kblueseek/GongChuang/docs/引脚分配表.md

# STM32F407VET6 引脚接线表（底盘 CAN 版）

> 依据当前工程实际配置整理：`UniversalCar.ioc` / `can.c` / `usart.c` / `tim.c` / `gpio.c` / `RobotConfig.h`
> 控制器：**STM32F407VET6**（LQFP100，512KB Flash / 192KB RAM）
> 系统时钟 168MHz（HSE **8MHz**，PLLM=4 / PLLN=168 / PLLP=2）
> 更新日期：2026-10-09
> ⚠️ 电机总线走 **CAN1**（500K 扩展帧，7 个 ZDT 电机并联，需 CAN 收发器）；电机固件为 **Emm**。

---

## 〇、接口总表（一张表看全部）

| 板上丝印 | MCU 引脚 | 外设 | 方向 | 接到哪 | 备注 |
|---|---|---|---|---|---|
| B9  | PB9  | CAN1_TX | 输出 | CAN 收发器 TXD | 500K 扩展帧 |
| B8  | PB8  | CAN1_RX | 输入 | CAN 收发器 RXD | 500K |
| A9  | PA9  | USART1_TX | 输出 | 调试上位机 RXD | 115200，DMA |
| A10 | PA10 | USART1_RX | 输入 | 调试上位机 TXD | 115200 |
| A2  | PA2  | USART2_TX | 输出 | （原蓝牙模组，已停用） | 115200 |
| A3  | PA3  | USART2_RX | 输入 | （原蓝牙模组，已停用） | 115200 |
| B10 | PB10 | USART3_TX | 输出 | JY901S RXD | 115200 |
| B11 | PB11 | USART3_RX | 输入 | JY901S TXD | 115200 |
| C6  | PC6  | USART6_TX | 输出 | 树莓派 RXD | 115200，**主链路：指令上行 + 遥测下行** |
| C7  | PC7  | USART6_RX | 输入 | 树莓派 TXD | 115200 |
| C10 | PC10 | UART4_TX | 输出 | （原 LoRa 模组，已停用） | 115200 |
| C11 | PC11 | UART4_RX | 输入 | （原 LoRa 模组，已停用） | 115200 |
| C12 | PC12 | UART5_TX | 输出 | （预留，原电机串口） | 已切 CAN |
| D2  | PD2  | UART5_RX | 输入 | （预留） | 已切 CAN |
| A6  | PA6  | TIM3_CH1 | 输出 | 舵机1 夹爪 信号 | 50Hz PWM |
| A7  | PA7  | TIM3_CH2 | 输出 | 舵机2 载物盘 信号 | 50Hz PWM |
| B0  | PB0  | TIM3_CH3 | 输出 | 舵机3 摄像头 信号 | 50Hz PWM |
| A13/A14 | PA13/PA14 | SWD | — | 下载排针 | ⚠️ 禁止外接 |
| H0/H1 | PH0/PH1 | HSE | — | 8MHz 无源晶振 | 负载电容 2×20pF |

---

## 一、电机 CAN 总线（CAN1，本次重点）

### 1.1 接线（CAN 多机并联）

CAN 是差分总线，**必须经过 CAN 收发器**（3.3V 逻辑 ↔ CAN_H/CAN_L），所有电机收发器并联在同一条总线上：

```
STM32 CAN1_TX (PB9) ──► 收发器.TXD
STM32 CAN1_RX (PB8) ◄── 收发器.RXD
收发器.CAN_H ─────────┬─────────┬─────────┬ ...（并到每个电机的 CAN_H）
收发器.CAN_L ─────────┼─────────┼─────────┼ ...（并到每个电机的 CAN_L）
GND ─────────────────┴─────────┴─────────┴ ...
```

- **CAN_H / CAN_L 全并联**，总线**两端各接一个 120Ω 终端电阻**（PCAN 端通常已带一个，另一端在电机总线末端补一个）。
- 波特率 **500K**，扩展帧，校验固定 **0x6B**。
- 多机靠**扩展帧 ID 区分地址**，全双工差分，不需要像串口那样分时问答。

### 1.2 电机地址表（CAN 扩展帧 ID = 地址<<8 | 包序号）

| 地址 | 电机 | 角色 | 控制模式 | 固件 |
|---|---|---|---|---|
| 1 | 底盘 前左 FL | 麦轮 | 速度模式（F6） | Emm |
| 2 | 底盘 前右 FR | 麦轮 | 速度模式（F6） | Emm |
| 3 | 底盘 后左 RL | 麦轮 | 速度模式（F6） | Emm |
| 4 | 底盘 后右 RR | 麦轮 | 速度模式（F6） | Emm |
| 5 | 云台 Yaw | 旋转轴 | 绝对位置模式（FD） | Emm |
| 6 | 云台 Lift | 升降轴 | 绝对位置模式（FD） | Emm |
| 7 | 云台 Extend | 伸缩轴 | 绝对位置模式（FD） | Emm |

> ⚠️ **每台电机都要用上位机把「通讯端口复用」设成 CAN(03)**，地址设成 1~7，波特率 500K，校验 0x6B。
> ⚠️ 固件是 **Emm**：速度命令 `F6 + 方向 + 速度(RPM) + 加速度档位 + 同步标志`，位置命令 `FD`，与 X 固件格式不同。

### 1.3 底盘多电机命令（0xAA）

底盘四个轮速用**多电机命令 0xAA** 打包成一条广播帧下发（`00 AA 长度 + 四条子命令 + 6B`，CAN 上按包序拆成扩展帧 ID `0000/0001/...`），四轮同步起步、只有地址 1 回 ACK，避免总线冲突。

### 1.4 编码器反馈（定时返回 0x36）

每台底盘电机配置了「定时返回实时位置 0x36」，每 `ZDT_FEEDBACK_PERIOD_MS`（默认 5ms）主动上报一次编码器位置（多圈累计，65536 计数 = 一圈），STM32 用整数计数差分积分成里程计，供回零位置闭环使用。

---

## 二、三个舵机（TIM3，50Hz / 20ms）

| 引脚 | 通道 | 舵机 | 上电初始角 |
|---|---|---|---|
| PA6 | TIM3_CH1 | 夹爪 | 90° |
| PA7 | TIM3_CH2 | 载物盘 | 0° |
| PB0 | TIM3_CH3 | 摄像头 | 90° |

- 信号线直接接 3.3V 电平即可（舵机高电平阈值一般 2.0~2.4V）。
- **电源线（红）走独立 5~6V 轨**，不要从单片机 3.3V 取；共地。

---

## 三、串口分配

| 串口 | 引脚 | 对象 | 波特率 | 说明 |
|---|---|---|---|---|
| USART1 | PA9/PA10 | 调试上位机 | 115200 | DMA 发送 DebugData 包 |
| USART2 | PA2/PA3 | （原蓝牙模组） | 115200 | 已停用（无线方案已换成有线） |
| USART3 | PB10/PB11 | JY901S | 115200 | ⚠️ 模块默认 9600，需先改成 115200 |
| USART6 | PC6/PC7 | 树莓派（有线） | 115200 | **主链路**：指令上行 + 遥测下行，全双工 |
| UART4 | PC10/PC11 | （原 LoRa 模组） | 115200 | 已停用（遥测改走 USART6） |
| UART5 | PC12/PD2 | 预留 | — | 原电机串口，已切 CAN |

---

## 四、电源与共地

| 设备 | 供电轨 | 备注 |
|---|---|---|
| 7 个步进电机 | 24V 直供 | 峰值电流大，主线加粗/铺铜 |
| CAN 收发器 | 3.3V / 5V | 按收发器型号供电 |
| 舵机 ×3 | 5~6V 独立轨 | 堵转 1~2A |
| STM32 核心板 | 5V | <0.5A |
| 树莓派 | 5V/5A | 独立电源，但 **GND 必须与 F407 共地**（有线串口 USART6） |

**F407 侧设备 GND 共地**：CAN 收发器、各串口、舵机、电源都要接到同一地平面。
**⚠️ 树莓派必须与 F407 共地**：现在走有线 USART6（全双工），UART 是电平信号，
没有公共地就没有电平参考，通信会乱码或完全不通。树莓派和 F407 的 GND 用一根线直连。

---

## 五、预留（本版未接线）

| 资源 | 引脚 | 用途 |
|---|---|---|
| UART5 | PC12/PD2 | 预留（原电机串口，已切 CAN） |
| UART4_RX | PC11 | LoRa 模组 TXD 接这里；当前方案只发不收，留作回传扩展 |
| TIM2_CH1 | PA5 | 补光灯 PWM（可选） |
| 硬件急停 | 任意 GPIO/EXTI | 未配置，预留 |
| 状态 LED | PC13 | 板载，当前代码未配置 |

---

## 六、接线顺序建议（Bring-up）

1. 先接 **CAN 电机总线**：接好 CAN 收发器，把 4 个底盘电机（+收发器）并联到 CAN_H/CAN_L，上位机把每台电机通讯端口切 CAN、设地址 1~4，PCAN/串口助手发 `01 36 6B` 读位置验证。
2. 再接 **3 个舵机**，上电确认回中位。
3. 接 **JY901S（USART3）**，先确认已改 115200。
4. 接 **树莓派有线串口**：F407 USART6（PC6=TX → 树莓派 GPIO15/RX，PC7=RX → 树莓派 GPIO14/TX），
   再拉一根 GND 共地，两边都 115200。验证：`ros2 launch lidar_bringup car_only.launch.py`，
   或单独跑桥接节点看日志里的「上行链路已连接」。
5. 最后接 **调试口（USART1）**。

---

## ⚠️ 容易踩的点

1. **晶振是 8MHz**：`.ioc` 配的是 HSE **8MHz**（PLLM=4 / PLLN=168 / PLLP=2）。接好前确认板载晶振确实是 8MHz，不是 25MHz，否则系统时钟不对。
2. **电机通讯模式**：每台电机默认/之前可能是串口模式，必须用上位机切成 **CAN** 并设对地址（1~7）、波特率 500K、校验 0x6B，否则对 CAN 命令没反应。
3. **CAN 收发器必接**：CAN 是差分信号，ST 的 PB8/PB9 是逻辑电平，不接收发器直接并线读不到也发不出。
4. **终端电阻**：总线两端各 120Ω，少了长线会反射、通讯不稳。
5. **固件 Emm**：速度/位置命令格式和 X 固件不同（速度=整数RPM+档位加速度，位置=FD），抄协议时别用 X 固件的格式。
6. **JY901S**：USART3 按 115200 配，但模块出厂默认 9600，需先用上位机改成 115200 再接线。

# 树莓派 已分配引脚
| 功能 | 接口 | BCM | 物理脚 | 电平/说明 |
| ---- | ---- | ---- | ---- | ---- |
| （原 STM32 LoRa TX） | UART2 | GPIO4 | 7 | 已停用（有线方案） |
| （原 STM32 LoRa RX） | UART2 | GPIO5 | 29 | 已停用（有线方案） |
| 状态屏 SDA | I2C1 | GPIO2 | 3 | OLED 1.96 寸，地址一般 0x3C |
| 状态屏 SCL | I2C1 | GPIO3 | 5 |  |
| STM32 有线 TX | UART0 | GPIO14 | 8 | 主链路，接 F407 USART6_RX（PC7） |
| STM32 有线 RX | UART0 | GPIO15 | 10 | 主链路，接 F407 USART6_TX（PC6） |
| 激光雷达 | USB | — | — | USB 转串口，固定为 /dev/ydlidar |
| 手柄 | USB | — | — | /dev/input/js0 |
| 补光灯 PWM | PWM0 | GPIO18 | 12 | 板上加 MOSFET，不能直驱 |
| 按键 1 | GPIO | GPIO17 | 11 | 上拉 + RC 消抖，云台限位示教：跳过当前轴 |
| 按键 2 | GPIO | GPIO22 | 15 | 同上，云台限位示教：当前轴重来 |
| 按键 3 | GPIO | GPIO23 | 16 | 同上，云台限位示教：记录当前点；非示教时翻屏 |
| 按键 4 | GPIO | GPIO24 | 18 | 同上，云台限位示教：退出示教 |

> 云台限位示教（status_display 节点）：开机后自动让 F407 把云台三轴松轴，按
> YAW → LIFT(Z) → EXTEND(X) 的顺序，把轴用手拨到想要的最小点/最大点，各按一次
> 按键 3 记录；结果保存到树莓派 `~/.ros/gimbal_limits.json` 并下发给 F407。
> 详细流程见 `raspberrypi/docs/树莓派构建指南.md`。
| OPS9 TX（预留） | UART5 | GPIO12 | 32 | 确认型号后启用 |
| OPS9 RX（预留） | UART5 | GPIO13 | 33 |  |
| I2C1 | I2C1 | GPIO2 / GPIO3 | 3 / 5 | 已给状态屏使用 |
| OPS9 备用 SPI | SPI0 | GPIO8/9/10/11 | 24/21/19/23 | CE0/MISO/MOSI/SCLK |
