kblueseek/GongChuang/raspberrypi/docs/树莓派构建指南.md

# 树莓派项目构建指南

目标平台：树莓派（推荐 4B/5）+ **Ubuntu 26.04** + **ROS2 Lyrical Luth**（Ubuntu 26.04 对应的 LTS 发行版）。

本文从零讲清：硬件接线 → 系统/ROS2 → 串口 → YDLIDAR 驱动 → 构建 → 运行 → 联调顺序 → 排错。

---

## 0. 角色与数据流

树莓派是决策层，F407 是执行层：

- 树莓派**只下发目标**（速度 / 云台角度 / 舵机 / 使能），电机 PID 闭环在 F407 上 20kHz 完成；
- F407 通过遥测回传里程计 `0x81`、整车状态 `0x83` 和云台三轴位置 `0x84`（里程计 50Hz、云台位置 20Hz、状态 5Hz，USART6 115200）；
- 树莓派串口与 F407 USART6（PC6/PC7，115200 8N1）直连，两端均为 **3.3V TTL**，共地即可，无需电平转换。

```
激光雷达 ──/scan──> obstacle_detect ──/obstacles──┐
                                                  v
上位机地图(扫描/识别/A*) ──/motion_load(序列)──> motion_planner ──/cmd_pose──┐
                                                  ^                          v
                                       ring_fix（视觉矫正 /set_odom）   f407_bridge ──PiComm(AA 55)──> F407 USART6
                                                  ^                          ^
                                        joy_control（手柄）          /odom /robot_status /odom_shift <──┘
```

---

## 1. 硬件接线

| 信号 | F407（USART6） | 树莓派 GPIO | 备注 |
|---|---|---|---|
| TX | PC6 | RXD（GPIO15，UART0_RX） | 交叉连接 |
| RX | PC7 | TXD（GPIO14，UART0_TX） | 交叉连接 |
| GND  | GND | GND | 必须共地 |
| 激光雷达 | —— | USB 口 | YDLIDAR X3 PRO 自带 USB 转串口 |

> 接线图参考仓库根目录 `docs/树莓派拓展版接线.png`。

---

## 2. 系统与 ROS2

1. 烧录 Ubuntu 26.04（Server 或 Desktop 均可；视觉需要图形环境，用 Desktop 更省事）。
2. 安装 ROS2 Lyrical Luth 桌面版，官方步骤（把页面里的发行版换成 `lyrical`）：
   <https://docs.ros.org/en/rolling/Installation/Ubuntu-Install-Debs.html>
3. 验证：
   ```bash
   source /opt/ros/lyrical/setup.bash
   ros2 --help
   ```

---

## 3. 串口（Pi ↔ F407）

Ubuntu 下在 `config.txt`（`/boot/firmware/config.txt` 或 `/boot/config.txt`）追加：

```
enable_uart=1
dtoverlay=disable-bt      # Pi 3/4 释放与蓝牙复用的 UART；Pi 5 可省略
```

重启后串口映射到 `/dev/serial0`（通常是 `/dev/ttyAMA0`）。验证：

```bash
ls -l /dev/serial0 /dev/ttyAMA0
```

> 首次联调可先脱离 ROS2 单独验证串口 + 协议，见 §6。

---

## 4. YDLIDAR X3 PRO 驱动

1. 建 udev 规则，把激光雷达固定成 `/dev/ydlidar`（脚本已生成，这里列出内容）：
   ```bash
   sudo tee /etc/udev/rules.d/ydlidar.rules >/dev/null <<'EOF'
   KERNEL=="ttyUSB*", ATTRS{idVendor}=="10c4", ATTRS{idProduct}=="ea60", MODE:="0666", SYMLINK+="ydlidar"
   EOF
   sudo udevadm control --reload-rules && sudo udevadm trigger
   ```
   > 若 `lsusb` 显示的 VID/PID 不是 `10c4:ea60`，据实修改。X3 PRO 用 CP2102 串口芯片。

2. 拉取并构建官方驱动（含 YDLidar-SDK 子模块）：
   ```bash
   cd ~/GongChuang/树莓派/ros2_ws/src
   git clone --recursive https://github.com/YDLIDAR/ydlidar_ros2_driver.git
   ```
   驱动参数见 [car_bringup/config/x3_pro.yaml](../ros2_ws/src/car_bringup/config/x3_pro.yaml)。

---

## 5. 构建与运行

```bash
cd ~/GongChuang/树莓派
bash scripts/setup.sh       # 依赖 + 串口 + udev + 驱动 clone + colcon build
sudo reboot
bash scripts/bringup.sh     # = ros2 launch car_bringup system.launch.py
```

单节点调试（不启动总 launch）：

```bash
source /opt/ros/lyrical/setup.bash
source ~/GongChuang/树莓派/ros2_ws/install/setup.bash

ros2 launch car_bringup x3_pro.launch.py    # 只起雷达，先确认有 /scan
ros2 run obstacle_detect obstacle_detect_node # 看 /obstacles
ros2 run f407_bridge f407_bridge_node         # 看 /odom /robot_status
ros2 run motion_planner motion_planner_node   # 状态机（/motion_load 下发序列）
ros2 run ring_fix ring_fix_node               # 圆环视觉矫正（calibrate 指令）
```

常用检查：

```bash
ros2 topic list
ros2 topic echo /scan --once            # 有数据说明雷达通
ros2 topic echo /obstacles              # [front, left, right, back] 米
ros2 topic echo /odom
ros2 topic echo /robot_status
```

---

## 5.5 云台限位示教（开机自动）

`status_display` 节点同时是限位示教面板：开机 3 秒后自动让 F407 把云台三轴**松轴**
（电机控制板失能，F3 AB 00），然后提示你用手把轴拨到想要的位置。

| 步骤 | 屏幕提示 | 操作 |
|---|---|---|
| 1/3 | `SETUP 1/3 YAW -> MIN point` | 手拨 Yaw 到最小点，按**按键3**（GPIO23） |
| 1/3 | `SETUP 1/3 YAW -> MAX point` | 拨到最大点，再按**按键3** |
| 2/3 | `SETUP 2/3 LIFT -> MIN/MAX` | Z 升降轴，同上两次 |
| 3/3 | `SETUP 3/3 EXT -> MIN/MAX` | X 伸缩轴，同上两次 |
| 完成 | `限位示教完成并已下发` | 恢复锁轴，限位立即生效 |

按键：

- **按键3 GPIO23**：记录当前点；非示教时翻页（状态 / 云台位置 / 限位）。
- **按键1 GPIO17**：跳过当前轴（保留上次保存的限位）。
- **按键2 GPIO22**：当前轴重来（丢掉刚记的最小点）。
- **按键4 GPIO24**：退出示教（已经记下的轴生效，其余用上次保存值）。

示教结果保存在 `~/.ros/gimbal_limits.json`，并通过 `0x0B` 下发给 F407；F407 之后
就按这组限位在速度指令上掐掉越界方向。节点在示教完成后还会 1Hz 重发一次限位，
F407 中途重启也能补上。

⚠️ **限位坐标是"相对 F407 上电位置"**：F407 每轴上电后第一次收到编码器反馈时把
那一刻锁存成 0 点。所以：
- 每次 F407 重新上电，0 点都会变，**建议每次开机都示教一遍**（默认自动进入）；
- 用按键4 跳过时下发的是上次保存的限位，只有"这次上电时轴的位置和上次一样"才准，
  屏幕第 3 页会显示 `OLD? re-teach if pose changed` 提醒；
- 示教过程中树莓派掉线，F407 会自动恢复锁轴并停发速度（安全兜底）。

相关参数（`status_display` 节点）：`auto_setup`（默认 true）、`startup_delay_s`（3.0）、
`min_span_deg`（20.0）、`limits_file`、四个 `button_*_pin`。

⚠️ **限位方向符号**：F407 判断限位前要把速度指令换算到编码器坐标，靠
`RobotConfig.h` 里的 `GIMBAL_YAW_CMD_SIGN` / `GIMBAL_LIFT_CMD_SIGN` /
`GIMBAL_EXTEND_CMD_SIGN`（+1 / -1）。编码器计数方向和电机转向相反的轴要填 -1
（出厂 Yaw 为 -1）。填反的现象是：顶到限位后**往回拨不动、继续往越界方向反而能动**。

---

## 6. 联调顺序（强烈建议按序）

不要一上来就发速度。按下面顺序逐步验证：

1. **心跳 / 状态**：先跑 `comm/pi_comm.py` 自检脚本，确认能收到 `0x83` 状态帧：
   ```bash
   python3 comm/pi_comm.py /dev/serial0
   ```
   收到 `状态: (state, err, motor_mask)` 且 `motor_mask == 0x7F`（7 个电机全在线）再继续。

2. **里程计**：推动小车，`/odom` 的 x/y/theta 应随之变化（单位/方向核对）。

3. **使能**：`ros2 topic pub /cmd_enable std_msgs/msg/Bool "data: true"`，F407 进入 `ROBOT_READY`。

4. **低速前进**：
   ```bash
   ros2 topic pub /cmd_vel geometry_msgs/msg/Twist \
     "{linear: {x: 0.1, y: 0.0, z: 0.0}, angular: {x: 0.0, y: 0.0, z: 0.0}}"
   ```

5. **急停**：任何异常立即 `ros2 topic pub /cmd_estop std_msgs/msg/Bool "data: true"`。

---

## 7. 单位与坐标系约定

- PiComm 速度帧：vx/vy 单位 **mm/s**，wz 单位 **mrad/s**（`encode_vel` 负责从 m/s、rad/s 换算）；
- 里程计帧：x/y 单位 **mm**，theta 单位 **mrad**（`parse_odom` 换算成 m、rad 后发 `/odom`）；
- 舵机角度 0~180°；
- `/obstacles`：`[front, left, right, back]`，单位米，`left` 为车辆左侧（90°），`right` 为 270°。

---

## 8. 已知事项 / TODO

- **协议迁移**：`vision/` 主程序仍用旧串口协议（`AA xx BB / CC xx DD`，见 `vision/串口通信协议.md`），
  与 PiComm（`AA 55 ...`）冲突。圆环工位识别已由 `ring_fix` 直接 import 检测器模块走 ROS2；
  其余模式（转盘/物料）的迁移方式相同。
- **视觉无头运行**：`vision/main.py` 用 `cv2.imshow` 显示窗口，无显示器环境需 X 转发或改造为
  headless（TODO）。
- **任务流程**：取放/码放由上位机组装指令序列（pick/place 宏、vision_pick、calibrate）下发
  motion_planner 执行，详见 [树莓派架构.md](树莓派架构.md)。

---

## 9. 常见问题

| 现象 | 排查 |
|---|---|
| `/scan` 无数据 | `ls -l /dev/ydlidar`；驱动是否 build 成功；USB 供电是否足够（换带供电的 USB HUB） |
| 串口收不到帧 | 检查 TX/RX 是否交叉、是否共地；`config.txt` 是否 `enable_uart=1`；波特率是否 115200（F407 与树莓派两端一致） |
| `motor_mask != 0x7F` | 对应电机离线或 CAN 未上电，查 F407 侧 CAN/电机电源 |
| 收到帧但 CRC 错 | 波特率不匹配、线材过长、或两边协议版本不一致——**逐字节核对 PiComm.c** |
| colcon build 失败 | 确认已 source ROS2；`python3-colcon-common-extensions` 已装 |
| 顶到限位后往回拨不动、越界方向能动 | 该轴的 `GIMBAL_xx_CMD_SIGN` 填反（`RobotConfig.h`），改 ±1 后重编 F407 |
