kblueseek/GongChuang/docs/下板.png

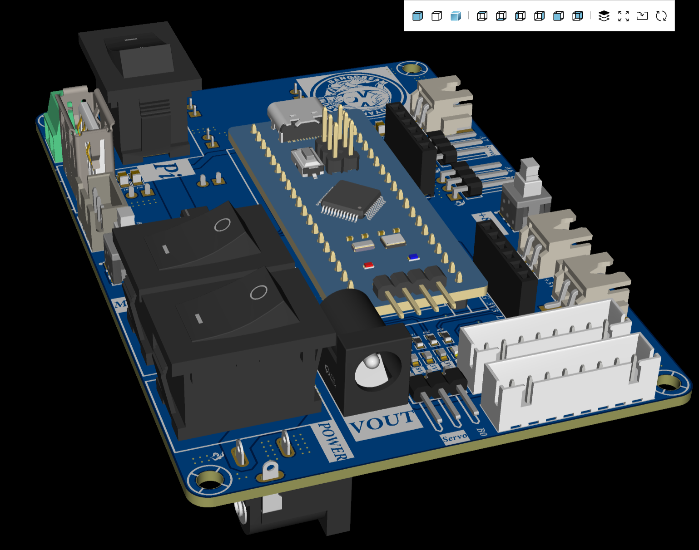
docs/下板.png
