kblueseek/GongChuang/docs/树莓派拓展版接线.png

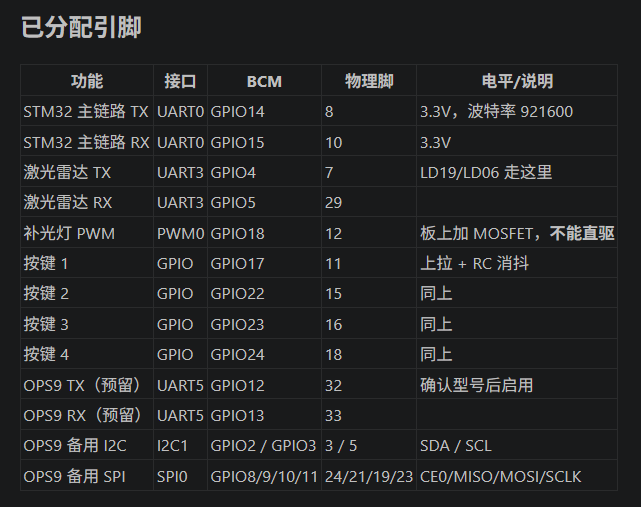
docs/树莓派拓展版接线.png
