kblueseek/GongChuang/docs/项目方案/图1_系统总体架构.png

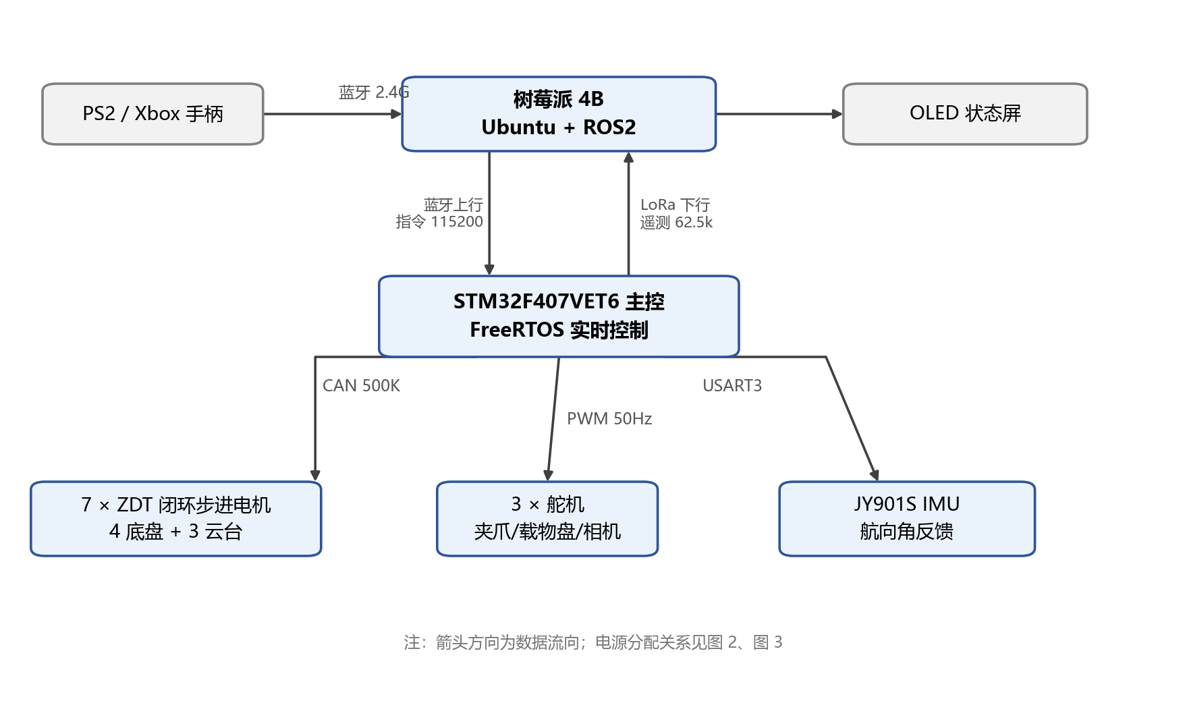
docs/项目方案/图1_系统总体架构.png
