kblueseek/GongChuang/UniversalCar/UniversalCar.ioc

Mcu.UserName=STM32F407VETx
PA10.Signal=USART1_RX
PA13.Signal=SYS_JTMS-SWDIO
PA14.Signal=SYS_JTCK-SWCLK
PA2.Signal=USART2_TX
PA3.Signal=USART2_RX
PA5.Signal=S_TIM2_CH1_ETR
PA6.Signal=S_TIM3_CH1
PA7.Signal=S_TIM3_CH2
PA9.Signal=USART1_TX
PB0.Signal=S_TIM3_CH3
PB10.Signal=USART3_TX
PB11.Signal=USART3_RX
PB8.Signal=CAN1_RX
PB9.Signal=CAN1_TX
PC10.Signal=UART4_TX
PC11.Signal=UART4_RX
PC12.Signal=UART5_TX
PC6.Signal=USART6_TX
PC7.Signal=USART6_RX
PD2.Signal=UART5_RX
PH0-OSC_IN.Signal=RCC_OSC_IN
PH1-OSC_OUT.Signal=RCC_OSC_OUT
