kblueseek/GongChuang/UniversalCar/ExHardware/ZdtMotor.c

/**
 * @attention   采用UTF-8字符集编码
 * @brief       ZDT Y42 闭环步进电机 CAN 控制封装（Emm 固件）
 * @details     电机内部闭环，STM32 侧不跑电流/速度环，直接下发速度或位置指令。
 *              采用注册机制维护地址表，统一了所有电机的维护与反馈解析。
 */

#include "header.h"

#define ZDT_CHECKSUM 0x6B
#define ZDT_TX_TIMEOUT_MS 1   /* 等空闲邮箱的最长时间（ms）：500k 下一帧约 250us，够等 3~4 次 */

ZdtMotor_t* ZdtMotorList[8] = { NULL };

/* 发送一帧（单包），扩展帧 ID = (地址<<8)|包序号 */
static uint8_t Zdt_SendFrame(uint8_t addr, uint8_t packet, const uint8_t* d, uint8_t n)
{
    CAN_TxHeaderTypeDef tx = { 0 };
    uint32_t mb;
    tx.ExtId = ((uint32_t)addr << 8) | packet;
    tx.IDE = CAN_ID_EXT;
    tx.RTR = CAN_RTR_DATA;
    tx.DLC = n;

    /* CAN1 只有 3 个 TX 邮箱，全满时 HAL_CAN_AddTxMessage 直接返回 HAL_ERROR（丢帧）。
       底盘任务背靠背连发一整串广播包，必须等空闲邮箱；但不能死等：bus-off 时 HAL 会
       一直立即返回错误，纯空转能把 10ms 任务卡十几毫秒。这里按时间封顶。
       现在全总线只有底盘任务发帧，不会再有另一个任务来抢邮箱（之前云台任务也发，
       两边互相挤，多包广播丢一包就整帧作废——"底盘卡住"、某轴"完全没反应"）。 */
    HAL_StatusTypeDef ret = HAL_CAN_AddTxMessage(&hcan1, &tx, (uint8_t*)d, &mb);
    uint32_t t0 = HAL_GetTick();
    while (ret != HAL_OK && (HAL_GetTick() - t0) < ZDT_TX_TIMEOUT_MS)
    {
        osThreadYield();
        ret = HAL_CAN_AddTxMessage(&hcan1, &tx, (uint8_t*)d, &mb);
    }
    return (ret == HAL_OK);
}

/* 低层发送：cmd[0] 为功能码，追加校验码后拆包发送。
   手册 4.2：CAN 拆包时每包首字节都要重复功能码，数据每包最多 7 字节，
   例如 12 字节命令拆成 "FD xx xx xx xx xx xx xx" + "FD xx xx xx 6B"。 */
static void Zdt_MotorSend(uint8_t addr, const uint8_t* cmd, uint8_t len)
{
    uint8_t func = cmd[0];
    uint8_t dataLen = len - 1;          /* 功能码之外的数据字节数 */
    uint8_t total = dataLen + 1;        /* 数据 + 校验码 */
    uint8_t sent = 0, packet = 0;

    while (sent < total) {
        uint8_t n = (total - sent > 7) ? 7 : (total - sent);
        uint8_t buf[8];
        buf[0] = func;                  /* 每包首字节重复功能码 */
        for (uint8_t i = 0; i < n; i++) {
            uint8_t idx = sent + i;
            buf[1 + i] = (idx < dataLen) ? cmd[1 + idx] : ZDT_CHECKSUM;
        }
        Zdt_SendFrame(addr, packet, buf, n + 1);
        sent += n;
        packet++;
    }
}

/* ============ 电机实例维护 ============ */

void ZdtMotor_Init(ZdtMotor_t* motor, uint8_t addr)
{
    motor->Addr = addr;
    motor->Speed.Set = 0;
    motor->Speed.Real = 0;
    motor->Position.Set = 0;
    motor->Position.Real = 0;
    motor->Position.RawCount = 0;
    motor->Status = 0;
    motor->HomeStatus = 0;
    motor->LastOnlineTick = 0;

    if (addr >= 1 && addr <= 7)
        ZdtMotorList[addr] = motor;
}

int ZdtMotor_IsOnline(ZdtMotor_t* motor)
{
    return (HAL_GetTick() - motor->LastOnlineTick) < ZDT_OFFLINE_MS;
}

/* ============ CAN 总线命令 ============ */

void ZdtCan_Init(void)
{
    CAN_FilterTypeDef f = { 0 };
    f.FilterActivation = CAN_FILTER_ENABLE;
    f.FilterBank = 0;
    f.FilterFIFOAssignment = CAN_RX_FIFO0;
    f.FilterIdHigh = 0;
    f.FilterIdLow = 0;
    f.FilterMaskIdHigh = 0;
    f.FilterMaskIdLow = 0;
    f.FilterMode = CAN_FILTERMODE_IDMASK;
    f.FilterScale = CAN_FILTERSCALE_32BIT;
    f.SlaveStartFilterBank = 14;    /* F4 双 CAN 时必须写，否则 HAL 返回 HAL_ERROR */
    HAL_CAN_ConfigFilter(&hcan1, &f);
    HAL_CAN_Start(&hcan1);
    HAL_CAN_ActivateNotification(&hcan1, CAN_IT_RX_FIFO0_MSG_PENDING);
}

void ZdtCan_Enable(uint8_t addr, uint8_t en)
{
    uint8_t c[] = { 0xF3, 0xAB, en ? 1 : 0, 0x00 };
    Zdt_MotorSend(addr, c, sizeof(c));
}

void ZdtCan_Stop(uint8_t addr)
{
    uint8_t c[] = { 0xFE, 0x98, 0x00 };
    Zdt_MotorSend(addr, c, sizeof(c));
}

void ZdtCan_SetZero(uint8_t addr)
{
    uint8_t c[] = { 0x0A, 0x6D };
    Zdt_MotorSend(addr, c, sizeof(c));
}

/* 解除堵转保护（手册 5.4.x：0x0E 0x52）。
   电机撞限位堵转后，固件会把保护标志【锁存】：位置反馈照常回（所以在状态掩码里显示
   在线），但拒绝一切速度/位置命令——表现就是"电机在线，可怎么按都不动"，
   必须掉电重启才恢复。这条命令就是软件侧的"重启"，使能时补一帧即可。 */
void ZdtCan_ClearStall(uint8_t addr)
{
    uint8_t c[] = { 0x0E, 0x52 };
    Zdt_MotorSend(addr, c, sizeof(c));
}

void ZdtCan_Home(uint8_t addr, uint8_t mode)
{
    uint8_t c[] = { 0x9A, mode, 0x00 };
    Zdt_MotorSend(addr, c, sizeof(c));
}

void ZdtCan_SyncAll(void)
{
    uint8_t c[] = { 0xFF, 0x66 };
    Zdt_MotorSend(0, c, sizeof(c));   /* 广播地址 0 */
}

void ZdtCan_ReadPos(uint8_t addr)
{
    uint8_t c[] = { 0x36 };
    Zdt_MotorSend(addr, c, sizeof(c));
}

void ZdtCan_ReadStatus(uint8_t addr)
{
    uint8_t c[] = { 0x3C };
    Zdt_MotorSend(addr, c, sizeof(c));
}

/* 定时返回信息命令（手册 5.5.1）：让电机每隔 interval_ms 自动上报指定信息，无需频繁轮询。
   func 为要返回的信息功能码：0x36=实时位置(4B,65536/圈)，0x35=实时转速(RPM)，0x3A=状态标志等。
   interval_ms=0 表示停止返回。 */
void ZdtCan_SetTimedReturn(uint8_t addr, uint8_t func, uint16_t interval_ms)
{
    uint8_t c[] = { 0x11, 0x18, func, interval_ms >> 8, interval_ms & 0xFF };
    Zdt_MotorSend(addr, c, sizeof(c));
}

/* ============ 多电机命令 (0xAA)：一条广播帧发多个电机命令，同时执行 ============ */
/* 手册 5.3.1：00 AA 总字节数(2) + 各子命令(地址+功能码/数据+校验码) + 校验码，
   地址 0 为广播，所有电机同时开始；CAN 上按功能码重复规则拆包。
   组帧缓冲放在 ctx 里、由调用任务持有。全总线只能有一个 0xAA 发送者：两条序列
   的 CAN ID 都是 0x000/0x001…，电机按包序号重组会串包，而 0x6B 是固定字节、
   拦不住错帧——串出来的帧会被电机当真执行。目前只有底盘任务在组广播帧。 */

void ZdtCan_MultiBegin(ZdtMulti_t* ctx)
{
    ctx->Len = 0;
}

/* 追加一条子命令：地址 + 功能码/数据 + 校验码 */
void ZdtCan_MultiAdd(ZdtMulti_t* ctx, uint8_t addr, const uint8_t* cmd, uint8_t len)
{
    if (ctx->Len + len + 2 > ZDT_MULTI_BUF_MAX)   /* 装不下就丢这一条，绝不越界 */
        return;

    ctx->Buf[ctx->Len++] = addr;
    for (uint8_t i = 0; i < len; i++)
        ctx->Buf[ctx->Len++] = cmd[i];
    ctx->Buf[ctx->Len++] = ZDT_CHECKSUM;
}

/* 广播发送整帧，按"每包首字节重复功能码 AA、每包最多 8 字节"拆包 */
void ZdtCan_MultiSend(ZdtMulti_t* ctx)
{
    if (ctx->Len == 0)
        return;

    uint16_t total = (uint16_t)(5 + ctx->Len);   /* 功能码1 + 长度2 + 子命令 + 校验1 */
    uint8_t* tx = ctx->Tx;
    uint16_t n = 0;
    tx[n++] = 0xAA;                       /* 功能码 */
    tx[n++] = (uint8_t)(total >> 8);      /* 长度高 */
    tx[n++] = (uint8_t)(total & 0xFF);    /* 长度低 */
    for (uint16_t i = 0; i < ctx->Len; i++)
        tx[n++] = ctx->Buf[i];
    tx[n++] = ZDT_CHECKSUM;

    /* tx[0]=AA 为功能码，tx[1..n-1] 为数据，按功能码重复规则拆包发送（地址0 → ExtId 0x0000） */
    uint16_t dataLen = n - 1;
    uint16_t sent = 0;
    uint8_t packet = 0;
    while (sent < dataLen) {
        uint8_t m = (dataLen - sent > 7) ? 7 : (uint8_t)(dataLen - sent);
        uint8_t buf[8];
        buf[0] = 0xAA;
        for (uint8_t i = 0; i < m; i++)
            buf[1 + i] = tx[1 + sent + i];
        Zdt_SendFrame(0, packet, buf, m + 1);
        sent += m;
        packet++;
    }
}

/* ============ 电机级命令 ============ */

/* 加速度档位按地址分组：1~4 底盘轮、5~7 云台三轴。
   云台要跟得紧（位置环/视觉跟踪），底盘要柔和起步，两者不能共用。 */
static uint8_t ZdtMotor_AccFor(uint8_t addr)
{
    return (addr >= ZDT_MOTOR_YAW) ? ZDT_GIMBAL_ACC : ZDT_WHEEL_ACC;
}

/* 速度模式（Emm 固件 F6）：dir + 速度(整数RPM,2B) + 加速度(档位,1B) + 同步标志 */
static uint8_t ZdtMotor_BuildSpeed(float rpm, uint8_t acc, uint8_t* out)
{
    uint8_t dir = (rpm >= 0) ? 0 : 1;
    uint16_t mag = (uint16_t)(fabsf(rpm));   /* RPM（整数，0~3000） */

    out[0] = 0xF6;
    out[1] = dir;
    out[2] = mag >> 8;
    out[3] = mag & 0xFF;
    out[4] = acc;
    out[5] = 0x00;
    return 6;
}

void ZdtMotor_SetSpeed(ZdtMotor_t* motor, float rpm)
{
    uint8_t c[6];
    ZdtMotor_BuildSpeed(rpm, ZdtMotor_AccFor(motor->Addr), c);
    Zdt_MotorSend(motor->Addr, c, sizeof(c));

    motor->Speed.Set = rpm;
}

/* 速度子命令追加到多电机缓冲（配合 ZdtCan_MultiBegin/Send，多轴同时启动） */
void ZdtMotor_MultiAddSpeed(ZdtMulti_t* ctx, ZdtMotor_t* motor, float rpm)
{
    uint8_t c[6];
    ZdtMotor_BuildSpeed(rpm, ZdtMotor_AccFor(motor->Addr), c);
    ZdtCan_MultiAdd(ctx, motor->Addr, c, sizeof(c));

    motor->Speed.Set = rpm;
}

/* 注意：驱动器内部位置模式（0xFD）整个工程都没有调用——云台是"位置环在
   GimbalTask 里算速度 → 只发速度帧(0xF6)"的架构。原来的 SetPosition /
   MultiAddPosition / BuildPosition 已删除，不要再加回来绕开上位机限幅。 */

/* ============ 接收解析 ============ */

void ZdtCan_RxCallback(uint32_t id, uint8_t* data, uint8_t len)
{
    uint8_t addr = (id >> 8) & 0xFF;
    if (addr == 0 || addr > 7)
        return;

    ZdtMotor_t* motor = ZdtMotorList[addr];
    if (motor == NULL)
        return;

    /* 拆包重组：>8 字节的返回帧按包序号拼接（本固件返回帧最长 8 字节，预留兼容） */
    switch (data[0]) {
    case 0x36:      /* 实时位置：符号(1) + 位置(4B 大端)，多圈累计，65536=一圈 */
        if (len >= 6) {
            int32_t v = (int32_t)((data[2] << 24) | (data[3] << 16) | (data[4] << 8) | data[5]);
            v = data[1] ? -v : v;
            motor->Position.RawCount = v;                  /* 原始整数计数，最高精度 */
            motor->Position.Real = v * 360.f / 65536.f;    /* 换算成角度 ° */
        }
        break;
    case 0x35:      /* 实时转速：符号(1) + 速度(2B, 整数RPM) */
        if (len >= 4) {
            int32_t v = (int32_t)((data[2] << 8) | data[3]);
            v = data[1] ? -v : v;
            motor->Speed.Real = v;               /* 整数 RPM */
        }
        break;
    case 0x3C:      /* 回零状态(1) + 电机状态(1) */
        if (len >= 3) {
            motor->HomeStatus = data[1];
            motor->Status = data[2];
        }
        break;
    default:
        break;
    }

    motor->LastOnlineTick = HAL_GetTick();
}
