kblueseek/GongChuang/raspberrypi/ros2_ws/src/f407_bridge/f407_bridge/pi_comm.py

#!/usr/bin/env python3
# -*- coding: utf-8 -*-
"""树莓派 <-> F407 通信（PiComm 协议）。

================ 链路 ================

  当前默认：有线。F407 USART6（全双工）<-> 树莓派 /dev/ttyAMA0，收发共用一条
            PiCommLink（send_xxx 发指令 + poll 收遥测），务必两边共地。
  保留可选：上行 BleLink（BLE GATT）/ RfcommLink（经典蓝牙 SPP）；下行 LoRa 串口。

所有链路跑的是同一套 PiComm 二进制帧，所以编解码代码完全复用。

================ 用大白话讲清楚这个文件在干什么 ================

这个文件负责一件事：把"命令"变成一串字节，通过串口发给 F407（STM32 单片机），
以及把 F407 发回来的一串字节，还原成"数据"。

为什么是一串字节？因为串口一次只能传一个字节（一个 0~255 的数）。
所以任何命令（比如"往前走 100mm/s"）都得先拆成一串数字，对方收到后再按同样的规则拼回来。
这个"拆和拼的规则"就是协议，这里叫 PiComm。

一帧数据长这样（"帧"就是一封完整的"信"）：

    AA 55 | LEN | SEQ | CMD | DATA | CRC
    头     | 长度 | 序号 | 命令 | 内容  | 校验

   AA 55 = 帧头，两个固定字节，表示"一封信开始了"（防止把噪声当成命令）
   LEN   = 这封信后面还有多少个字节（让接收方知道要收多长）
   SEQ   = 序号，每发一封 +1，只是方便观测，不影响功能
   CMD   = 命令编号，比如 1=速度、4=夹爪、8=急停
   DATA  = 命令的具体内容，比如速度是多少
   CRC   = 校验码，像"防伪码"，接收方算一遍对不上就说明传错了，丢掉

注意：CRC 的算法、覆盖哪些字节、字节先后顺序，都必须和 F407 那边写的代码
（UniversalCar/ExHardware/PiComm.c）完全一致，差一点就通信失败。
"""

# 下面这行是固定写法：让 Python 把类型提示（比如 -> int 这种）推迟处理，避免一些加载顺序问题。
from __future__ import annotations

import asyncio  # bleak 是异步库，蓝牙收发都要在 asyncio 事件循环里做
import queue    # 线程安全队列：ROS 回调只往里丢帧，蓝牙线程负责真正写出去
import struct   # struct 用来做"数字 <-> 字节"的转换（打包/解包），是二进制协议的核心工具
import threading
import time     # 提供计时功能，用来做串口断线后的"过几秒再重连"
from typing import Callable, Optional

# 尝试导入串口库 pyserial。如果电脑上没装，也不报错——因为"编解码"这部分不依赖串口，
# 只有真正要打开串口收发时才需要它。
try:
    import serial
except ImportError:
    serial = None

# 蓝牙库 bleak（树莓派上的 BLE 中央设备）。同样允许缺失：只用 LoRa/串口时不需要它。
try:
    from bleak import BleakClient, BleakScanner
except ImportError:
    BleakClient = None
    BleakScanner = None


# ==================== 命令编号 ====================
# 这些数字是"命令的名字"，和 F407 侧 PiComm.h 里的定义一一对应，改这里必须改那边。
CMD_VEL = 0x01        # 速度指令（前进/后退/旋转）
CMD_GIMBAL = 0x02     # 云台转到某个角度（绝对位置模式，上位机/序列用）
CMD_HOME = 0x03       # 云台回零（回原点）
CMD_GIMBAL_VEL = 0x08 # 云台速度模式（°/s，手柄摇杆用）
CMD_GRIPPER = 0x04    # 夹爪舵机
CMD_PLATE = 0x05      # 托盘舵机
CMD_CAM = 0x06        # 相机舵机
CMD_ENABLE = 0x07     # 整车使能/失能（单一状态，1=使能 0=失能）
CMD_POSE = 0x09       # 位姿目标（走到世界系 (x,y) 并转到朝向 yaw，底盘位置+航向闭环）
CMD_LED = 0x0A        # 补光灯亮度（0~100%，PWM 调光）
CMD_GIMBAL_LIMIT = 0x0B    # 云台单轴限位（示教结果下发）
CMD_GIMBAL_RELEASE = 0x0C  # 云台三轴松轴/恢复（限位示教时人手拨动）
CMD_TUNE = 0x0D       # 在线调参（id + float32）：最大速度 / 位置环 PID / 转向环 PID / 云台位置环 PID
CMD_GIMBAL_ZERO = 0x0E  # 云台置零：把三轴此刻的编码器位置定义成 0 点
CMD_HEARTBEAT = 0x10  # 心跳（定期发一次，告诉 F407 "我还活着"）

# ==================== 回传数据编号 ====================
# 这些是 F407 主动发给树莓派的"数据编号"（方向反过来）。编号都 >= 0x80，用最高位区分方向。
RPT_ODOM = 0x81        # 里程计（车走了多远、朝向多少）
RPT_STATUS = 0x83      # 整车状态（状态、错误码、电机在线情况）
RPT_GIMBAL = 0x84      # 云台三轴位置（相对 0 点，单位 °）
RPT_TUNE = 0x85        # 调参回显（id + float32）：确认 407 当前生效值
RPT_GIMBAL_LIMIT = 0x86  # 云台单轴限位（轴号 + 是否有效 + 下限 + 上限）

# 帧头两个字节
SOF1 = 0xAA
SOF2 = 0x55
MAX_FRAME = 64   # 一帧最长 64 字节，必须和 F407 那边的接收缓冲区一样大

# ==================== 错误标志位 ====================
# F407 会在状态帧里用一个数表示"出了什么错"，每一位代表一种错误。
# 这里只是"照抄一份"，让树莓派端能看懂。真正生效的判断在 F407 的 ReceiveTask.c 里。
# 注意：以最新固件 UniversalCar/Task/ReceiveTask.c 为准，目前只置 bit0。
ERR_PI_OFFLINE = 1 << 0   # 第0位：树莓派离线（心跳断了）
ERR_ESTOP = 1 << 1        # 第1位：急停（固件预留，当前不置位）
ERR_MOTOR_LOST = 1 << 2   # 第2位：有电机掉线（固件预留，当前不置位）

# ==================== 整车状态机的三种状态 ====================
ROBOT_DISABLED = 0   # 未使能（电机没上电）
ROBOT_READY = 1      # 就绪（可以接收运动指令）
ROBOT_FAULT = 2      # 故障


class PiCommError(ValueError):
    """我们自己定义的异常，专门表示"协议出错"（比如数值越界、帧太长）。

    单独定义这个类，好处是调用方可以只捕获它，而不会误吞别的错误。
    """


def crc16_modbus(data: bytes) -> int:
    """算 CRC16-MODBUS 校验码。

    校验码的作用：发送方根据内容算出一个 16 位的数，接收方收到后用同样算法再算一遍，
    对得上说明数据传输没出错；对不上就说明传错/被干扰了，直接丢弃。

    这个算法是"标准"的，多项式 0xA001、初值 0xFFFF，不能改——因为 F407 那边用同一套。
    """
    crc = 0xFFFF                 # 初值固定为 0xFFFF
    for byte in data:            # 一个一个字节处理
        crc ^= byte              # 把当前字节"混"进校验值里（异或）
        for _ in range(8):       # 每个字节要处理 8 位（一个字节=8位）
            # 看最低位是不是 1：是 1 就先右移再异或 0xA001；是 0 就直接右移
            crc = (crc >> 1) ^ 0xA001 if (crc & 1) else crc >> 1
    return crc & 0xFFFF          # 只保留低 16 位（校验码是 16 位）


def build_frame(cmd: int, data: bytes = b"", seq: int = 0) -> bytes:
    """把一条命令打包成一整帧字节（就是那封"信"）。

    参数：
        cmd  = 命令编号（比如 CMD_VEL）
        data = 命令内容（字节串，可为空）
        seq  = 序号
    返回：完整的帧字节串
    """
    # 先做两个合法性检查：命令号必须在 0~255；帧不能太长。
    if not 0 <= cmd <= 0xFF:
        raise PiCommError(f"功能码越界：{cmd}")
    n = len(data)                 # 内容有几个字节
    if 3 + n > MAX_FRAME:         # 整帧长度 = 命令(1) + 内容(n) + 校验(2) = 3+n
        raise PiCommError(f"帧过长：{3 + n} > {MAX_FRAME}")

    # bytearray 是一个可以往里逐个"追加"字节的容器（像可以不断 push 的列表）
    frame = bytearray()
    frame.append(SOF1)            # 第1字节：帧头 AA
    frame.append(SOF2)            # 第2字节：帧头 55
    frame.append(3 + n)           # 第3字节：LEN = 后面还有多少字节（命令+内容+校验）
    frame.append(seq & 0xFF)      # 第4字节：序号（& 0xFF 保证是 0~255）
    frame.append(cmd)             # 第5字节：命令号
    frame.extend(data)            # 接着放：内容
    # 计算校验码：从"LEN"字节开始算（frame[2:] 表示从第3个字节到结尾），
    # 也就是覆盖 LEN + SEQ + CMD + DATA，和协议规定一致。
    crc = crc16_modbus(bytes(frame[2:]))
    frame.append(crc & 0xFF)          # 校验码的低 8 位放前面（小端）
    frame.append((crc >> 8) & 0xFF)   # 校验码的高 8 位放后面
    return bytes(frame)               # 转成不可变字节串返回


# ==================== 各命令的内容打包 ====================
# 下面的函数都只负责把"人看得懂的数值"变成"协议要的字节"，不负责发出去。

def encode_vel(vx_m_s: float, vy_m_s: float, wz_rad_s: float) -> bytes:
    """速度指令的内容：三个方向的速度，各占 2 字节（int16，大端）。

    注意单位换算：我们平时用 m/s、rad/s（弧度/秒），但协议传的是 mm/s、mrad/s（毫弧度/秒）。
    为什么？因为整数比小数好传，而且 1mm/s 的精度对小车足够。
    """
    vx = int(round(vx_m_s * 1000.0))     # m/s 乘 1000 变成 mm/s，再四舍五入成整数
    vy = int(round(vy_m_s * 1000.0))
    wz = int(round(wz_rad_s * 1000.0))   # rad/s 乘 1000 变成 mrad/s
    # int16 的取值范围是 -32768 ~ 32767，超出说明给的速度不合理，直接报错，不要默默溢出。
    for name, val in (("vx", vx), ("vy", vy), ("wz", wz)):
        if not -32768 <= val <= 32767:
            raise PiCommError(f"{name} 超出 int16：{val}")
    # struct.pack(">hhh", ...)：把三个整数打包成字节。
    #   ">"  = 大端（高位字节在前，和 F407 解析顺序一致）
    #   "hhh" = 三个 int16
    return struct.pack(">hhh", vx, vy, wz)


def encode_pose(x_m: float, y_m: float, yaw_rad: float) -> bytes:
    """位姿目标指令内容：x(int32 毫米) + y(int32 毫米) + yaw(int16 毫弧度)，共 10 字节。

    这是状态机的核心指令：告诉 F407 "走到世界系 (x,y)，并把朝向转到 yaw"。
    剩下的位置闭环（4 个电机编码器积分里程计）和航向闭环（陀螺仪）都由 F407 自己做。
    """
    x = int(round(x_m * 1000.0))       # 米 → 毫米
    y = int(round(y_m * 1000.0))
    t = int(round(yaw_rad * 1000.0))   # 弧度 → 毫弧度
    for name, val in (("x", x), ("y", y)):
        if not -2147483648 <= val <= 2147483647:   # int32 范围
            raise PiCommError(f"{name} 超出 int32：{val}")
    if not -32768 <= t <= 32767:                   # int16 范围（±18°，远超 ±π 弧度=±3142）
        raise PiCommError(f"yaw 超出 int16：{t}")
    return struct.pack(">iih", x, y, t)   # >iih = 两个 4 字节整数 + 一个 2 字节整数


def encode_gimbal(axis: int, deg: float) -> bytes:
    """云台目标指令内容：轴编号(1字节) + 角度(4字节 int32，单位是 0.01 度)。

    角度存成"角度×100"的整数，是为了保留两位小数精度（比如 45.5 度存成 4550）。
    """
    if axis not in (0, 1, 2):
        raise PiCommError(f"云台轴越界：{axis}")
    return struct.pack(">Bi", axis, int(round(deg * 100.0)))  # B=1字节无符号, i=4字节整数


def encode_gimbal_vel(axis: int, deg_per_s: float) -> bytes:
    """云台速度指令内容：轴编号(1字节) + 角速度(2字节 int16，单位 °/s)。

    电机 F6 速度模式本来就是整数 RPM（1RPM=6°/s），所以 1°/s 的整数精度已经
    足够，比电机的分辨率还细。
    """
    if axis not in (0, 1, 2):
        raise PiCommError(f"云台轴越界：{axis}")
    spd = int(round(deg_per_s))
    if not -32768 <= spd <= 32767:
        raise PiCommError(f"云台速度超出 int16：{spd}")
    return struct.pack(">Bh", axis, spd)  # B=1字节无符号, h=2字节 int16


def encode_gimbal_limit(axis: int, min_deg: float, max_deg: float) -> bytes:
    """云台单轴限位（0x0B）：轴号(1字节) + 下限(int16, ×0.1°) + 上限(int16, ×0.1°)。

    这两个角度是"相对云台 0 点"的坐标，和云台位置回传 0x84 完全同一套坐标：
    示教/上位机标定时看到多少，就原样发回来。F407 收到后覆盖 RobotConfig.h 的默认限位。
    """
    if axis not in (0, 1, 2):
        raise PiCommError(f"云台轴越界：{axis}")
    lo = int(round(min_deg * 10.0))
    hi = int(round(max_deg * 10.0))
    if lo > hi:
        lo, hi = hi, lo
    for name, val in (("min", lo), ("max", hi)):
        if not -32768 <= val <= 32767:
            raise PiCommError(f"{name} 超出 int16：{val}")
    return struct.pack(">Bhh", axis, lo, hi)


def encode_gimbal_release(en: bool) -> bytes:
    """云台松轴（0x0C）：1 字节，1=松轴（电机控制板失能，可手拨），0=恢复锁轴。"""
    return bytes([1 if en else 0])


def encode_gimbal_zero(mask: int) -> bytes:
    """云台置零（0x0E）：1 字节，bit0=yaw bit1=lift bit2=extend。

    收到后 F407 把对应轴此刻的编码器值定义成 0 点，之前示教/保存的限位仍然
    相对这个 0 点生效。电机掉电不保存位置，所以每次上电先人工摆到固定位再置零。
    """
    return bytes([mask & 0x07])


# 调参 ID，和 F407 的 PiComm.h 一一对应。
TUNE_MAX_VX = 0x01      # 前进最大速度 m/s
TUNE_MAX_VY = 0x02      # 平移最大速度 m/s
TUNE_MAX_WZ = 0x03      # 转向最大角速度 rad/s
TUNE_MAX_RPM = 0x04     # 单轮最大转速 RPM
TUNE_POS_KP = 0x05      # 位置环 Kp
TUNE_POS_KI = 0x06
TUNE_POS_KD = 0x07
TUNE_HEAD_KP = 0x08     # 转向环 Kp
TUNE_HEAD_KI = 0x09
TUNE_HEAD_KD = 0x0A
TUNE_GIMBAL_KP = 0x0B   # 云台 yaw 位置环 Kp（误差 ° → 速度 °/s）
TUNE_GIMBAL_KI = 0x0C
TUNE_GIMBAL_KD = 0x0D
TUNE_GIMBAL_LIFT_KP = 0x0E   # 云台 lift 位置环（yaw/lift/extend 独立整定）
TUNE_GIMBAL_LIFT_KI = 0x0F
TUNE_GIMBAL_LIFT_KD = 0x10
TUNE_GIMBAL_EXT_KP = 0x11   # 云台 extend 位置环
TUNE_GIMBAL_EXT_KI = 0x12
TUNE_GIMBAL_EXT_KD = 0x13
TUNE_GIMBAL_YAW_SPEED = 0x14   # 云台 yaw 最大速度 °/s（位置环输出限幅）
TUNE_GIMBAL_LIFT_SPEED = 0x15
TUNE_GIMBAL_EXT_SPEED = 0x16


def encode_tune(param_id: int, value: float) -> bytes:
    """在线调参指令（0x0D）：参数编号(1字节) + 数值(float32 大端)，共 5 字节。

    F407 收到后立即改运行参数（不烧录），并回一帧 0x85 回显当前生效值。
    上位机滑杆拖动时高频调用，帧很小，115200 下毫无压力。
    """
    if not 0 <= int(param_id) <= 0xFF:
        raise PiCommError(f"调参编号越界：{param_id}")
    return struct.pack(">Bf", int(param_id), float(value))


def parse_tune(data: bytes) -> tuple[int, float]:
    """解析调参回显帧（0x85），返回 (参数编号, 当前生效值)。"""
    if len(data) != 5:
        raise PiCommError(f"调参回显帧长度应为5，实际{len(data)}")
    param_id, value = struct.unpack(">Bf", data)
    return param_id, float(value)


def encode_home(mask: int) -> bytes:
    """云台回零指令内容：一个字节，每一位代表一个轴要不要回零。"""
    return bytes([mask & 0x07])   # 只保留低 3 位（3 个轴）


def encode_servo(pos_deg: float) -> bytes:
    """舵机角度内容：一个字节，0~180 度（舵机一般就是 0~180）。"""
    if not 0.0 <= pos_deg <= 180.0:
        raise PiCommError(f"舵机角度越界：{pos_deg}")
    return bytes([int(round(pos_deg))])   # 四舍五入成整数，塞进 1 个字节


def encode_led(brightness_percent: float) -> bytes:
    """补光灯亮度内容：一个字节，0~100（百分比）。"""
    if not 0.0 <= brightness_percent <= 100.0:
        raise PiCommError(f"补光灯亮度越界：{brightness_percent}")
    return bytes([int(round(brightness_percent))])   # 四舍五入成整数，塞进 1 个字节


def encode_enable(en: bool) -> bytes:
    """使能指令内容：1 字节 = 是否使能(1/0)。"""
    return bytes([1 if en else 0])


# ==================== 回传数据的解析 ====================
# 下面的函数把 F407 发回来的字节，还原成人能看懂的数。和上面的 encode 正好相反。

def parse_odom(data: bytes) -> tuple[float, float, float]:
    """解析里程计帧（0x81），返回 (x米, y米, 朝向弧度)。

    帧内容是：x(int32 毫米) y(int32 毫米) theta(int16 毫弧度)，共 10 字节。
    """
    if len(data) != 10:
        raise PiCommError(f"里程计帧长度应为10，实际{len(data)}")
    x_mm, y_mm, theta_mrad = struct.unpack(">iih", data)  # 解包：两个4字节整数 + 一个2字节整数
    return x_mm / 1000.0, y_mm / 1000.0, theta_mrad / 1000.0  # 换成 米、米、弧度


def parse_status(data: bytes) -> tuple[int, int, int]:
    """解析状态帧（0x83），返回 (状态, 错误码, 电机在线掩码)。"""
    if len(data) != 3:
        raise PiCommError(f"状态帧长度应为3，实际{len(data)}")
    return data[0], data[1], data[2]   # 三个字节依次对应三个含义


def parse_gimbal(data: bytes) -> tuple[float, float, float]:
    """解析云台位置帧（0x84），返回 (yaw°, lift°, extend°)。

    三个 int16，单位 0.1°，坐标是"相对云台 0 点"。0 点由 PI_CMD_GIMBAL_ZERO
    定义（上电时先是第一次收到反馈的位置，人工摆到固定位后置零即可）。
    """
    if len(data) != 6:
        raise PiCommError(f"云台位置帧长度应为6，实际{len(data)}")
    yaw, lift, extend = struct.unpack(">hhh", data)
    return yaw / 10.0, lift / 10.0, extend / 10.0


def parse_gimbal_limit(data: bytes) -> tuple[int, bool, float, float]:
    """解析云台限位帧（0x86），返回 (轴号, 是否有效, 下限°, 上限°)。

    帧内容：轴号(1字节) + valid(1字节) + 下限(int16, ×0.1°) + 上限(int16, ×0.1°)。
    valid=False 表示这轴还没被示教/上位机下发过，值是固件默认值。
    """
    if len(data) != 6:
        raise PiCommError(f"云台限位帧长度应为6，实际{len(data)}")
    axis, valid, lo, hi = struct.unpack(">BBhh", data)
    return int(axis), bool(valid), lo / 10.0, hi / 10.0


class PiCommLink:
    """维护一个串口连接，负责"自动重连 + 发命令 + 收数据"。

    特点：
      1. 非阻塞——读写不会卡住整个程序（ROS2 节点不能卡）；
      2. 自动重连——串口拔了再插、F407 重启，都会自动恢复；
      3. 收数据时能自动"找帧头、拼帧、校验"，坏数据自动丢。
    """

    def __init__(
        self,
        device: str = "/dev/ttyAMA0",   # 串口设备名（树莓派的串口）
        baudrate: int = 115200,         # 波特率，必须和 F407 一致
        reconnect_interval_s: float = 1.0,  # 断线后隔几秒再尝试重连
        serial_factory: Callable = serial.Serial if serial else None,  # 串口"工厂"（测试时可替换）
        clock: Callable[[], float] = time.monotonic,  # 时钟（测试时可替换）
    ):
        if serial_factory is None:
            raise PiCommError("未安装 pyserial，无法创建串口")
        self.device = str(device)
        self.baudrate = int(baudrate)
        self.reconnect_interval_s = float(reconnect_interval_s)
        self._serial_factory = serial_factory
        self._clock = clock
        self._port = None            # 当前串口对象，None 表示未连接
        self._rx = bytearray()       # 接收缓冲区：存还没拼成完整帧的字节
        self._seq = 0                # 发送序号
        self._next_reconnect_s = 0.0 # 下次允许重连的时间点
        self.last_error = ""         # 最近一次错误信息（供外部查看）

    # ---------- 连接管理 ----------
    @property
    def connected(self) -> bool:
        """是否已连上串口。"""
        return bool(self._port is not None and getattr(self._port, "is_open", True))

    def _disconnect(self, error: str) -> None:
        """断开连接：关串口、清缓冲区、推迟下次重连时间。"""
        if self._port is not None:
            try:
                self._port.close()
            except (OSError, Exception):
                pass
        self._port = None
        self._rx.clear()   # 半截数据作废
        self._next_reconnect_s = self._clock() + self.reconnect_interval_s  # 1 秒后再试
        self.last_error = str(error)

    def _ensure_connected(self) -> bool:
        """确保已连接：已连接就返回 True；没连且到时间了就去连；没到时间就返回 False。"""
        if self.connected:
            return True
        if self._clock() < self._next_reconnect_s:   # 还没到重连时间，别急着连
            return False
        try:
            # 读用 timeout=0（非阻塞，靠 in_waiting 判断有没有数据）；
            # 写必须给一个正超时：write_timeout=0 时若系统发送缓冲满，write() 只写入一部分，
            # 下面会判定"帧被截断"→ 断开重连（1s 内上下行全停）。云台速度模式下上行帧变多，
            # 这个截断更容易发生，表现就是状态屏 F407 在 ON/OFF 之间快速闪。
            self._port = self._serial_factory(
                port=self.device,
                baudrate=self.baudrate,
                timeout=0,
                write_timeout=0.1,
            )
        except Exception as error:
            self._disconnect(str(error))
            return False
        self.last_error = ""
        return True

    # ---------- 发送 ----------
    def _send(self, cmd: int, data: bytes = b"") -> bool:
        """内部发送函数：打包 -> 写入串口 -> 序号+1。返回是否成功。"""
        if not self._ensure_connected():
            return False
        frame = build_frame(cmd, data, self._seq)   # 打包成一帧
        try:
            written = self._port.write(frame)       # 写出去，返回写了几个字节
            if written != len(frame):               # 没写完整 = 异常
                raise serial.SerialTimeoutException(
                    f"只写入 {written}/{len(frame)} 字节"
                )
        except Exception as error:
            self._disconnect(str(error))            # 写失败 -> 断开，等重连
            return False
        self._seq = (self._seq + 1) & 0xFF          # 序号 +1，超过 255 就回到 0
        return True

    # 下面这些是"对外接口"：名字一看就知道发什么命令，内部再调用 _send。
    # 上层代码只需要写 link.send_vel(...)，不用记 0x01 这种数字。
    def send_vel(self, vx_m_s: float, vy_m_s: float, wz_rad_s: float) -> bool:
        return self._send(CMD_VEL, encode_vel(vx_m_s, vy_m_s, wz_rad_s))

    def send_pose(self, x_m: float, y_m: float, yaw_rad: float) -> bool:
        return self._send(CMD_POSE, encode_pose(x_m, y_m, yaw_rad))

    def send_gimbal(self, axis: int, deg: float) -> bool:
        return self._send(CMD_GIMBAL, encode_gimbal(axis, deg))

    def send_gimbal_vel(self, axis: int, deg_per_s: float) -> bool:
        return self._send(CMD_GIMBAL_VEL, encode_gimbal_vel(axis, deg_per_s))

    def send_gimbal_limit(self, axis: int, min_deg: float, max_deg: float) -> bool:
        return self._send(CMD_GIMBAL_LIMIT, encode_gimbal_limit(axis, min_deg, max_deg))

    def send_gimbal_release(self, en: bool) -> bool:
        return self._send(CMD_GIMBAL_RELEASE, encode_gimbal_release(en))

    def send_gimbal_zero(self, mask: int) -> bool:
        return self._send(CMD_GIMBAL_ZERO, encode_gimbal_zero(mask))

    def send_tune(self, param_id: int, value: float) -> bool:
        return self._send(CMD_TUNE, encode_tune(param_id, value))

    def send_home(self, mask: int) -> bool:
        return self._send(CMD_HOME, encode_home(mask))

    def send_gripper(self, deg: float) -> bool:
        return self._send(CMD_GRIPPER, encode_servo(deg))

    def send_plate(self, deg: float) -> bool:
        return self._send(CMD_PLATE, encode_servo(deg))

    def send_cam(self, deg: float) -> bool:
        return self._send(CMD_CAM, encode_servo(deg))

    def send_led(self, brightness_percent: float) -> bool:
        return self._send(CMD_LED, encode_led(brightness_percent))

    def send_enable(self, en: bool) -> bool:
        return self._send(CMD_ENABLE, encode_enable(en))

    def send_heartbeat(self) -> bool:
        return self._send(CMD_HEARTBEAT)

    # ---------- 接收 ----------
    def poll(self) -> list[tuple[int, bytes]]:
        """非阻塞地收一次数据，返回 [(命令号, 内容), ...] 列表。

        因为串口是"流"（字节一个接一个来），一次 read 可能只收到半帧，
        所以要先把字节攒进缓冲区，再尝试从中"切"出完整的帧。
        """
        if not self._ensure_connected():
            return []
        try:
            available = int(getattr(self._port, "in_waiting", 0))  # 串口里攒了多少字节没读
            if available <= 0:
                return []                        # 没数据，直接返回空
            data = self._port.read(available)    # 把积压的字节一次性读出来
        except Exception as error:
            self._disconnect(str(error))
            return []

        self._rx.extend(data or b"")   # 追加到接收缓冲区
        frames: list[tuple[int, bytes]] = []

        # 循环：尽量从缓冲区里切出完整帧
        while True:
            idx = self._rx.find(b"\xaa\x55")   # 找帧头 AA 55 的位置
            if idx < 0:
                # 没找到帧头：说明这堆字节不是有效数据，全丢掉。
                # 但有个小细节：如果最后恰好残留一个 0xAA（可能是下一帧帧头的前半截），
                # 就把它留着，等下一批数据补上 0x55。
                if self._rx and self._rx[-1] == SOF1:
                    del self._rx[:-1]
                else:
                    self._rx.clear()
                break
            if idx > 0:
                del self._rx[:idx]   # 帧头前面有杂散字节，丢掉它们
            if len(self._rx) < 4:    # 连"长度"字节都还没收齐（至少4字节才能读长度），继续等
                break
            length = self._rx[2]     # 第3个字节是 LEN（帧长）
            total = length + 4       # 整帧总长 = 帧头(2) + LEN + SEQ + LEN字节
            if length + 3 > MAX_FRAME:
                del self._rx[0]      # 长度异常（说明已经失步），丢掉1个字节重新找帧头
                continue
            if len(self._rx) < total:  # 还没收满一整帧，继续等
                break
            candidate = bytes(self._rx[:total])     # 取出一整帧
            crc = (candidate[-1] << 8) | candidate[-2]  # 帧尾两个字节拼成校验码
            if crc16_modbus(candidate[2:-2]) == crc:   # 重新算一遍，和帧里的比对
                # 校验通过：取出 (命令号=第5字节, 内容=中间那段)，收下
                frames.append((candidate[4], candidate[5:-2]))
            # 不管校验过没过，这一帧都要从缓冲区移除（坏帧直接丢弃）
            del self._rx[:total]
        return frames

    def close(self) -> None:
        """关闭串口，释放资源（程序退出前调用）。"""
        if self._port is not None:
            try:
                self._port.close()
            except Exception:
                pass
        self._port = None
        self._rx.clear()


# ==================== 蓝牙上行链路 ====================
#
# 为什么不能直接用 BleakClient 发？
#   bleak 是"异步"库，所有收发都必须在一个 asyncio 事件循环里进行；而 ROS2 的回调
#   是普通同步函数，直接调用会报错、或者把节点卡住。所以这里的做法是：
#     1. 单独开一个后台线程，里面跑一个 asyncio 事件循环，负责连接/重连/写数据；
#     2. ROS 回调只把"要发的帧"塞进一个线程安全队列（queue.Queue），立刻返回；
#     3. 后台线程从队列取帧，写进 BLE 特征值。
#   队列满时丢最旧的帧——遥测/心跳这类周期命令丢一帧没关系，最新值才重要。

# 常见的"串口透传"BLE 模组的特征值 UUID：
#   NUS（Nordic UART Service）：很多国产模组（JDY 系列、AT-09 改写版）用这个
BLE_NUS_WRITE_UUID = "6e400002-b5a3-f393-e0a9-e50e24dcca9e"   # 中央设备写入
BLE_NUS_NOTIFY_UUID = "6e400003-b5a3-f393-e0a9-e50e24dcca9e"  # 模组 notify 给中央设备
#   FFE1：老牌 HC-08 / CC2541 透传模组常用
BLE_FFE1_UUID = "0000ffe1-0000-1000-8000-00805f9b34fb"
# 广播里出现这些片段，说明这台设备大概率是串口透传模组
_BLE_SERIAL_MARKS = ("6e400001", "0000ffe0", "0000ffe1", "0000fff0")


def _ble_device_uuids(device) -> set[str]:
    """从 bleak 扫到的设备对象里，尽量把广播中的服务 UUID 抠出来。

    不同版本/不同平台的 bleak 把广播数据放在不同位置（metadata 或 details），
    所以这里两种都试一遍，取不到就返回空集合（不影响后续按名字匹配）。
    """
    uuids: set[str] = set()
    metadata = getattr(device, "metadata", None) or {}
    if isinstance(metadata, dict):
        for item in metadata.get("uuids", []) or []:
            uuids.add(str(item).lower())
    details = getattr(device, "details", None) or {}
    if isinstance(details, dict):
        props = details.get("props", {}) or {}
        for item in props.get("UUIDs", []) or []:
            uuids.add(str(item).lower())
    return uuids


def _ble_looks_like_serial(device) -> bool:
    """这台设备的广播里有没有"串口透传"服务的痕迹。"""
    for uuid in _ble_device_uuids(device):
        for mark in _BLE_SERIAL_MARKS:
            if mark in uuid:
                return True
    return False


def scan_ble_devices(timeout: float = 8.0) -> list[tuple[str, str, list[str]]]:
    """同步扫描附近 BLE 设备，返回 [(地址, 名称, 广播服务UUID列表), ...]。

    主要给调试脚本用：先看清 F407 上的蓝牙模组叫什么名字、地址是多少，
    再把 ble_address / ble_name 填进桥接节点，就不用每次盲扫了。
    """
    if BleakScanner is None:
        raise PiCommError("未安装 bleak，无法扫描蓝牙（sudo apt install python3-bleak）")

    async def _scan():
        return await BleakScanner.discover(timeout=timeout)

    found = asyncio.run(_scan())
    result = []
    for dev in found:
        result.append((
            getattr(dev, "address", "") or "",
            getattr(dev, "name", "") or "",
            sorted(_ble_device_uuids(dev)),
        ))
    return result


class BleLink:
    """BLE 上行链路：把 PiComm 帧写进蓝牙模组的串口透传特征值。

    和 PiCommLink 提供同名接口（send_vel / send_pose / send_heartbeat ...），
    上层节点可以无差别替换。区别：
      * 只有发送，没有 poll()（遥测走 LoRa，不占蓝牙）；
      * 连接是异步的，构造后立刻返回，后台线程自己连、断了自动重连；
      * connected 只是"最近一次连接状态"，发不出去不会抛异常（只丢帧 + 记录 last_error）。
    """

    def __init__(
        self,
        address: str = "",              # 模组 MAC 地址（Linux 上是 AA:BB:CC:DD:EE:FF）；空=自动扫描
        name: str = "",                 # 按名字关键字匹配（比如 "JDY"、"BLE"）；空=不限
        write_uuid: str = "",           # 写入特征值 UUID；空=自动探测 NUS/FFE1/第一个可写特征
        scan_timeout: float = 8.0,      # 扫描多久找设备
        reconnect_interval_s: float = 2.0,  # 断线后隔多久重连
        queue_size: int = 64,           # 待发帧队列长度
        log: Optional[Callable[[str], None]] = None,   # 日志输出（节点传 get_logger().info 进来）
    ):
        if BleakClient is None:
            raise PiCommError(
                "未安装 bleak，无法使用蓝牙链路（sudo apt install python3-bleak）"
            )
        self.address = str(address or "")
        self.name = str(name or "")
        self.write_uuid = str(write_uuid or "")
        self.scan_timeout = float(scan_timeout)
        self.reconnect_interval_s = float(reconnect_interval_s)
        self.last_error = ""
        self.last_scan_report = ""

        self._log_fn = log
        self._frames: "queue.Queue[bytes]" = queue.Queue(maxsize=max(4, int(queue_size)))
        self._stop = threading.Event()
        self._connected = threading.Event()
        self._seq = 0

        self._thread = threading.Thread(target=self._thread_main, name="ble-link", daemon=True)
        self._thread.start()

    # ---------- 对外状态 ----------
    @property
    def connected(self) -> bool:
        return self._connected.is_set()

    def _log(self, text: str) -> None:
        if self._log_fn is not None:
            try:
                self._log_fn(text)
            except Exception:
                pass

    # ---------- 发送（ROS 回调里调用，必须立刻返回） ----------
    def _send(self, cmd: int, data: bytes = b"") -> bool:
        frame = build_frame(cmd, data, self._seq)
        self._seq = (self._seq + 1) & 0xFF
        if not self.connected:
            # 没连上就丢掉，别攒着——重连后一次性灌一堆旧指令反而危险
            return False
        try:
            self._frames.put_nowait(frame)
        except queue.Full:
            try:
                self._frames.get_nowait()   # 丢最旧的
            except queue.Empty:
                pass
            try:
                self._frames.put_nowait(frame)
            except queue.Full:
                return False
        return True

    def send_vel(self, vx_m_s: float, vy_m_s: float, wz_rad_s: float) -> bool:
        return self._send(CMD_VEL, encode_vel(vx_m_s, vy_m_s, wz_rad_s))

    def send_pose(self, x_m: float, y_m: float, yaw_rad: float) -> bool:
        return self._send(CMD_POSE, encode_pose(x_m, y_m, yaw_rad))

    def send_gimbal(self, axis: int, deg: float) -> bool:
        return self._send(CMD_GIMBAL, encode_gimbal(axis, deg))

    def send_gimbal_vel(self, axis: int, deg_per_s: float) -> bool:
        return self._send(CMD_GIMBAL_VEL, encode_gimbal_vel(axis, deg_per_s))

    def send_gimbal_limit(self, axis: int, min_deg: float, max_deg: float) -> bool:
        return self._send(CMD_GIMBAL_LIMIT, encode_gimbal_limit(axis, min_deg, max_deg))

    def send_gimbal_release(self, en: bool) -> bool:
        return self._send(CMD_GIMBAL_RELEASE, encode_gimbal_release(en))

    def send_gimbal_zero(self, mask: int) -> bool:
        return self._send(CMD_GIMBAL_ZERO, encode_gimbal_zero(mask))

    def send_tune(self, param_id: int, value: float) -> bool:
        return self._send(CMD_TUNE, encode_tune(param_id, value))

    def send_home(self, mask: int) -> bool:
        return self._send(CMD_HOME, encode_home(mask))

    def send_gripper(self, deg: float) -> bool:
        return self._send(CMD_GRIPPER, encode_servo(deg))

    def send_plate(self, deg: float) -> bool:
        return self._send(CMD_PLATE, encode_servo(deg))

    def send_cam(self, deg: float) -> bool:
        return self._send(CMD_CAM, encode_servo(deg))

    def send_led(self, brightness_percent: float) -> bool:
        return self._send(CMD_LED, encode_led(brightness_percent))

    def send_enable(self, en: bool) -> bool:
        return self._send(CMD_ENABLE, encode_enable(en))

    def send_heartbeat(self) -> bool:
        return self._send(CMD_HEARTBEAT)

    def poll(self) -> list[tuple[int, bytes]]:
        """蓝牙只做上行（遥测走 LoRa），所以这里永远返回空。保留接口是为了和 PiCommLink 通用。"""
        return []

    def close(self) -> None:
        self._stop.set()
        self._thread.join(timeout=2.0)

    # ---------- 后台线程：asyncio 连接 / 重连 / 发送 ----------
    def _thread_main(self) -> None:
        loop = asyncio.new_event_loop()
        asyncio.set_event_loop(loop)
        try:
            loop.run_until_complete(self._run_forever())
        finally:
            self._connected.clear()
            loop.close()

    async def _run_forever(self) -> None:
        while not self._stop.is_set():
            try:
                address = self.address or await self._discover_address()
                if not address:
                    self.last_error = "没有找到可用的蓝牙模组（可用 scripts/ble_scan.py 查看）"
                    await asyncio.sleep(self.reconnect_interval_s)
                    continue
                self.address = address

                async with BleakClient(address, timeout=10.0) as client:
                    uuid = await self._resolve_write_uuid(client)
                    if uuid is None:
                        raise RuntimeError("连上了但找不到可写特征值，请用 ble_write_uuid 指定")
                    self.write_uuid = uuid
                    self._drain()
                    self._connected.set()
                    self.last_error = ""
                    self._log(f"蓝牙已连接 {address}，写入特征值 {uuid}")
                    await self._pump(client, uuid)
            except Exception as error:      # 任何异常都当作断线，统一重连
                self.last_error = str(error)
                self._log(f"蓝牙断开：{error}（{self.reconnect_interval_s:.0f}s 后重连）")
            finally:
                self._connected.clear()

            if not self._stop.is_set():
                await asyncio.sleep(self.reconnect_interval_s)

    async def _pump(self, client, uuid: str) -> None:
        """连接期间一直从队列取帧写出去；连接掉了就退出，交给外层重连。"""
        while not self._stop.is_set():
            if not client.is_connected:
                raise RuntimeError("蓝牙连接已断开")
            try:
                frame = await asyncio.to_thread(self._frames.get, True, 0.5)
            except queue.Empty:
                continue
            try:
                await client.write_gatt_char(uuid, frame, response=False)
            except Exception:
                # 有些模组只支持"带响应"的写
                await client.write_gatt_char(uuid, frame, response=True)

    def _drain(self) -> None:
        """清空待发队列（刚连上时把断线期间积累的旧帧扔掉）。"""
        while True:
            try:
                self._frames.get_nowait()
            except queue.Empty:
                return

    async def _discover_address(self) -> str:
        """扫描附近设备，挑出 F407 上的蓝牙模组。"""
        devices = await BleakScanner.discover(timeout=self.scan_timeout)
        lines = []
        candidates = []
        for dev in devices:
            dev_name = getattr(dev, "name", "") or ""
            dev_addr = getattr(dev, "address", "") or ""
            uuids = sorted(_ble_device_uuids(dev))
            lines.append(f"  {dev_addr}  {dev_name or '(无名)'}  {','.join(uuids[:3])}")
            if self.name and self.name.lower() in dev_name.lower():
                self.last_scan_report = "\n".join(lines)
                return dev_addr
            if _ble_looks_like_serial(dev):
                candidates.append(dev_addr)
        self.last_scan_report = "\n".join(lines) or "  (没有扫到任何 BLE 设备)"

        if len(candidates) == 1:
            return candidates[0]
        if not self.name:
            # 没有指定名字时，退一步：只认有名字的设备（避免连到一堆无名信标）
            named = [getattr(d, "address", "") for d in devices if (getattr(d, "name", "") or "")]
            if len(named) == 1:
                return named[0]
        self.last_error = (
            "扫描到多台设备，无法自动确定哪台是 F407 的蓝牙模组：\n"
            + self.last_scan_report
            + "\n请用 ble_address 或 ble_name 参数指定。"
        )
        self._log(self.last_error)
        return ""

    async def _resolve_write_uuid(self, client) -> Optional[str]:
        """在已连接的 GATT 表里找到"能把数据写进模组串口"的那个特征值。"""
        if self.write_uuid:
            return self.write_uuid

        writable = []
        for service in client.services:
            for char in service.characteristics:
                props = {p.lower() for p in char.properties}
                if "write" in props or "write-without-response" in props:
                    writable.append(str(char.uuid).lower())

        for preferred in (BLE_NUS_WRITE_UUID, BLE_FFE1_UUID):
            if preferred in writable:
                return preferred
        return writable[0] if writable else None


class RfcommLink(PiCommLink):
    """经典蓝牙 SPP 模组（HC-05 / HC-06 这类）当成串口用。

    经典蓝牙不能走 BLE GATT，得先用系统命令把 /dev/rfcomm0 绑上：
        sudo rfcomm bind 0 <模组MAC> 1
    之后它对程序来说就是一个普通串口文件，直接用 PiCommLink 读写的逻辑。
    """

    def __init__(self, device: str = "/dev/rfcomm0", baudrate: int = 115200, **kwargs):
        super().__init__(device=device, baudrate=baudrate, **kwargs)
        self.write_uuid = ""    # 和 BleLink 保持同样的属性，方便上层统一处理


if __name__ == "__main__":
    # 直接运行这个文件（不通过 ROS2），用来单独测试串口和协议是否打通：
    #   python3 comm/pi_comm.py /dev/ttyAMA0
    # 它会每秒发一次心跳，并把收到的帧打印出来。
    import sys

    device = sys.argv[1] if len(sys.argv) > 1 else "/dev/ttyAMA0"  # 从命令行读设备名
    link = PiCommLink(device=device)
    print(f"PiComm 自检：{device} @ {link.baudrate}，Ctrl-C 退出")
    last_hb = 0.0
    try:
        while True:
            for cmd, data in link.poll():   # 收数据并打印
                if cmd == RPT_ODOM:
                    print(f"  里程计: {parse_odom(data)}")
                elif cmd == RPT_STATUS:
                    print(f"  状态: {parse_status(data)}")
                else:
                    print(f"  帧: cmd=0x{cmd:02X} data={data.hex()}")
            now = time.monotonic()
            if now - last_hb >= 1.0:        # 每秒发一次心跳
                last_hb = now
                link.send_heartbeat()
                print(f"[{now:.0f}] heartbeat sent, connected={link.connected}")
            time.sleep(0.01)
    except KeyboardInterrupt:
        print("\n退出")
    finally:
        link.close()
