kblueseek/GongChuang/raspberrypi/ros2_ws/src/car_bringup/config/vehicle.yaml

# 整车集中配置（对标 F407 的 RobotConfig.h）
#
# 树莓派侧所有"装一次车 / 换一次场地 / 换设备"要调的参数全部集中在这一个文件，
# launch 只负责拉节点、把本文件传下去——ROS 只会应用与节点名匹配的那一节。
#
# ⚠ 改完重启 run_car.sh 生效。vision_args 里的仓库路径要改成树莓派上的实际路径。

motion_planner:
  ros__parameters:
    # ---- gimbal_yaw / gimbal_lift / gimbal_ext 单轴相对微调的"到位"判据 ----
    # 指令发出去后阻塞等 /gimbal_state 的实测角进 ±tol 才走下一句，所以序列里
    # 后面不用再写 delay。给小了会"没到位就继续"，给大了只是慢一点。
    # 超时（秒）到了只报警、继续执行，不会卡死任务。
    gimbal_arrive_tol_deg: 2.0
    gimbal_arrive_timeout_s: 2.5
    # ---- 云台位置目标续命（F407 只保持 3s，过期就退回速度模式停下）----
    # 下发 gimbal 目标后按 0.5s 重发，直到三轴都进 ±tol；序列结束进入 idle
    # 后仍继续，防止最后一条 gimbal 指令"走一半停住"。keepalive_s 是安全上限。
    gimbal_keepalive_s: 30.0
    gimbal_keepalive_tol_deg: 2.0
    # 绝对 gimbal 指令默认阻塞等三轴到位再执行下一条（大角度移动要留足时间）。
    # 超时只报警继续；确认要"发了就走"时在该条指令里写 "wait": false。
    gimbal_abs_arrive_timeout_s: 20.0
    # 状态机推进频率。10Hz 时"到位后最多多等 100ms"，20Hz → 50ms。
    # 云台位置回传是 20Hz，再往上吃不到新数据，只多占上行位姿帧。
    tick_hz: 20.0
    # ---- color_pick 的视觉端（云台跟随抓取跟踪器）----
    # 路径支持 $HOME 变量（motion_planner 启动子程序前会展开），
    # 这样仓库放在哪个用户名下都不用改。脚本不存在时 color_pick 会静默失败，
    # 状态栏只报"视觉程序没有返回 JSON"。
    vision_program: 'python3'
    vision_args: '$HOME/GongChuang/raspberrypi/vision/gimbal_track_pick.py'
    # color_pick 开始跟随前先等物料静止多久（秒）。转盘转到抓取位会停一下 → 0.3；
    # 物料一直在动、或者想尽快出第一条云台指令就设 0（检测到就追，会跟着转）。
    vision_still_time_s: 0.3
    # ---- number_put / double_put 放置位姿（三环独立查表）----
    # 标定方法：车开到位 → calibrate 对位 → 用"夹爪微动+暂停"逐环试放：
    #   每次放到环 N 成功时，读 /gimbal_state（或 PID 页"当前"）的 yaw/lift/extend
    #   填入 place_ringN_*。量三个填三个，不做线性假设。
    # double_put = 同环角度 + lift 再抬高 stack_lift_deg（叠在第一批上方）。
    place_ring1_yaw_deg: 0.0
    place_ring1_extend_deg: 0.0
    place_ring1_lift_deg: 0.0
    place_ring2_yaw_deg: 0.0
    place_ring2_extend_deg: 150.0
    place_ring2_lift_deg: 0.0
    place_ring3_yaw_deg: 0.0
    place_ring3_extend_deg: 0.0
    place_ring3_lift_deg: 0.0
    place_safe_lift_deg: 0.0
    stack_lift_deg: 0.0
    # ---- 载物盘三个料位角度（tray_slot 指令用）。实测法：手柄按住 L1 步进转盘到
    #      "能接住物料"的位置，ros2 topic echo /cmd_servo --once 读目标角填入。
    #      0/60/120 是示例分布，必须按你的机构实测 ----
    # place_tray（放到载物盘）转 yaw 期间 ext 先收到的角度：力臂最短、转动
    # 惯量最小，带料转大角度不抖。和 yaw 同时开始，靠 ext 速度上限（调参 0x16）
    # 让它几百毫秒就收完。填机构完全收回的位置；单条指令写 retract_deg 可覆盖。
    place_tray_retract_extend_deg: -100.0
    tray_slot1_deg: 180.0
    tray_slot2_deg: 92.0
    tray_slot3_deg: 7.0
    # ---- vision_pick/color_pick 抓取位姿兜底与整体偏移（视觉 JSON 缺字段时用；
    #      offset 加在视觉输出上，机械标定修正不用改视觉程序）----
    pick_default_yaw_deg: 0.0
    pick_default_lift_deg: 0.0
    pick_default_extend_deg: 0.0
    pick_safe_lift_deg: 0.0
    pick_gripper_open_deg: 100.0
    pick_gripper_close_deg: 173.0
    pick_settle_ms: 800
    pick_yaw_offset_deg: 0.0
    pick_lift_offset_deg: 0.0
    pick_extend_offset_deg: 0.0
    # ---- calibrate（圆环视觉矫正）等待上限 ----
    calibrate_timeout_s: 1000.0

ring_fix:
  ros__parameters:
    # 圆环工位视觉矫正：触发时才开摄像头
    camera_device: '/dev/video0'
    # 对准后车体相对中间环的偏移（odom 系，米）：默认 0 = 对准位置即输入坐标。
    # 标定：手动对准后读 odom 减去圆环坐标填入；align_yaw_deg 留空 = 只修位置不修航向
    align_offset_x_m: 0.0
    align_offset_y_m: 0.0
    align_yaw_deg: ''
    timeout_s: 45.0

qr_scanner:
  ros__parameters:
    # 扫码模块：树莓派 UART3（TX=GPIO4 / RX=GPIO5）。
    # Pi5 需 /boot/firmware/config.txt 加 dtoverlay=uart3-pi5 重启；
    # USB 转接模块把 device 改成 /dev/ttyUSB0
    device: '/dev/ttyAMA3'
    baudrate: 115200
    # 模块没接时节点每 2s 重试一次，但同样的错误最多每 60s 报一次，不刷屏。
    retry_interval_s: 2.0
    warn_repeat_s: 60.0

f407_bridge:
  ros__parameters:
    # F407 链路：有线 / BLE 上行 + LoRa 下行（见 docs/无线链路搭建.md）
    uplink: 'wire'
    wire_device: '/dev/ttyAMA0'
    wire_baudrate: 115200
    downlink: 'wire'

joy_control:
  ros__parameters:
    # 手柄按键控制夹爪的开/合角度
    gripper_open_deg: 100.0
    gripper_close_deg: 173.0
    # 载物盘（L1 按住步进）：每 tick 步进角度 / 方向（顺反了改 -1.0）
    servo_step_deg: 5.0
    plate_dir: 1.0

status_display:
  ros__parameters:
    # OLED 状态屏分辨率（160x80 的屏改成 160 / 80）
    width: 128
    height: 64
