kblueseek/GongChuang/raspberrypi/ros2_ws/src/f407_bridge/f407_bridge/f407_bridge_node.py

#!/usr/bin/env python3
# -*- coding: utf-8 -*-
"""F407 桥接节点：ROS2 世界和 F407 单片机之间的"翻译官"（有线版）。

================ 大白话：这个节点在干什么 ================

树莓派和 F407 现在用一根全双工有线串口直连（USART6 ↔ /dev/ttyAMA0），收发共用一条链路：

    上行（树莓派 → F407）：把 /cmd_vel、/cmd_servo 等话题翻译成 PiComm 帧，写进串口。
    下行（F407 → 树莓派）：F407 把里程计/状态帧从 USART6 发回，本节点当串口收。

⚠️ 有线直连必须两边共地（GND 接 GND），否则电平没有参考点，通信会乱码或根本不通。

================ 可配置参数（ros2 param） ================

  uplink         wire | ble | rfcomm     上行方式，默认 wire
  downlink       wire | lora            下行方式，默认 wire
  wire_device    有线串口，默认 /dev/ttyAMA0（GPIO14=TX / GPIO15=RX）
  ble_address    蓝牙模组 MAC（留空=自动扫描）
  ble_name       蓝牙模组名字关键字（留空=不限）
  ble_write_uuid 写入特征值 UUID（留空=自动探测）
  rfcomm_device  经典蓝牙串口（rfcomm bind 出来的口），默认 /dev/rfcomm0
  lora_device    LoRa 串口设备，默认 /dev/ttyAMA2（Pi5 加 dtoverlay=uart2-pi5 后）
  lora_baudrate  LoRa 串口波特率，默认 115200（必须和模组、F407 一致）
  frame_id       里程计坐标系名，默认 odom

改方式举例：
  ros2 run f407_bridge f407_bridge_node --ros-args -p uplink:=rfcomm -p downlink:=wire
"""

import math   # 用于算四元数（姿态的一种数学表示）

import rclpy
from rclpy.node import Node
from geometry_msgs.msg import Quaternion, Twist   # Quaternion=四元数, Twist=速度
from car_interfaces.msg import Pose2D             # 自定义平面位姿(x,y,theta)
from nav_msgs.msg import Odometry                 # 里程计消息
from std_msgs.msg import Bool, Float32MultiArray, Int32, Int32MultiArray

# 从本包内导入协议模块（以本包这份为准；comm/pi_comm.py 是旧脚本用的历史副本）
from f407_bridge.pi_comm import (
    BleLink,          # 蓝牙上行（BLE GATT）
    PiCommLink,       # 串口链路（LoRa 下行 / 有线备用）
    RfcommLink,       # 经典蓝牙 SPP（当串口用）
    RPT_ODOM,         # 回传数据编号：里程计
    RPT_STATUS,       # 回传数据编号：状态
    RPT_GIMBAL,       # 回传数据编号：云台三轴位置
    RPT_TUNE,         # 回传数据编号：调参回显
    RPT_GIMBAL_LIMIT, # 回传数据编号：云台单轴限位
    parse_odom,       # 解析里程计的函数
    parse_status,     # 解析状态的函数
    parse_gimbal,     # 解析云台位置的函数
    parse_tune,       # 解析调参回显的函数
    parse_gimbal_limit,  # 解析云台限位的函数
)

# F407 超过这么久没有任何回传，就认为它掉线了（状态 5Hz + 里程计 20Hz，1.5s 足够宽容）
F407_OFFLINE_TIMEOUT_S = 1.5


class F407BridgeNode(Node):
    def __init__(self):
        super().__init__('f407_bridge')   # 节点名

        # ================= 参数声明 =================
        self.declare_parameter('uplink', 'wire')                 # wire / ble / rfcomm
        self.declare_parameter('ble_address', '')                # 留空=自动扫描
        self.declare_parameter('ble_name', '')                   # 留空=不限
        self.declare_parameter('ble_write_uuid', '')             # 留空=自动探测
        self.declare_parameter('ble_scan_timeout', 8.0)
        self.declare_parameter('rfcomm_device', '/dev/rfcomm0')
        self.declare_parameter('wire_device', '/dev/ttyAMA0')
        self.declare_parameter('wire_baudrate', 115200)          # 必须和 F407 USART6 一致
        self.declare_parameter('downlink', 'wire')               # wire / lora
        self.declare_parameter('lora_device', '/dev/ttyAMA2')
        self.declare_parameter('lora_baudrate', 115200)
        self.declare_parameter('frame_id', 'odom')

        # ================= 建链路 =================
        self._up, self._down = self._make_links()

        # ================= 方向1：订阅话题（ROS2 -> F407） =================
        self.create_subscription(Twist, '/cmd_vel', self._cb_cmd_vel, 10)
        self.create_subscription(Float32MultiArray, '/cmd_servo', self._cb_cmd_servo, 10)
        self.create_subscription(Bool, '/cmd_enable', self._cb_cmd_enable, 10)
        self.create_subscription(Pose2D, '/cmd_pose', self._cb_cmd_pose, 10)
        self.create_subscription(Float32MultiArray, '/cmd_gimbal', self._cb_cmd_gimbal, 10)
        self.create_subscription(Float32MultiArray, '/cmd_gimbal_vel', self._cb_cmd_gimbal_vel, 10)
        self.create_subscription(Int32, '/cmd_gimbal_home', self._cb_cmd_gimbal_home, 10)
        self.create_subscription(Int32, '/cmd_led', self._cb_cmd_led, 10)
        # 限位示教结果：[轴号, 下限°, 上限°]；松轴开关：True=松轴
        self.create_subscription(Float32MultiArray, '/cmd_gimbal_limit', self._cb_cmd_gimbal_limit, 10)
        self.create_subscription(Bool, '/cmd_gimbal_release', self._cb_cmd_gimbal_release, 10)
        # 云台置零：掩码 bit0=yaw bit1=lift bit2=extend，把当前位置定义成 0 点
        self.create_subscription(Int32, '/cmd_gimbal_zero', self._cb_cmd_gimbal_zero, 10)
        # 在线调参：[参数编号, 数值]，编号见 pi_comm.py 的 TUNE_*
        self.create_subscription(Float32MultiArray, '/cmd_tune', self._cb_cmd_tune, 10)
        # 里程计重置（圆环视觉矫正用）：/set_odom 把"修正坐标系"锚定到车的真实位姿。
        # 本节点在 /odom 上报时加偏移、在 /cmd_pose 下发时减偏移，ROS 侧统一活在
        # 修正系，F407 内部始终用它自己的原始里程计系。
        self.create_subscription(Pose2D, '/set_odom', self._cb_set_odom, 10)
        self._pub_odom_shift = self.create_publisher(Pose2D, '/odom_shift', 10)
        self._odom_offset = (0.0, 0.0, 0.0)   # (t_x, t_y, t_yaw)：odom' = t + R(t_yaw)·odom
        self._last_raw_odom = None            # 最近一次 F407 原始里程计 (x, y, yaw)

        # ================= 方向2：发布话题（F407 -> ROS2） =================
        self._pub_odom = self.create_publisher(Odometry, '/odom', 10)
        self._pub_status = self.create_publisher(Int32MultiArray, '/robot_status', 10)
        self._pub_gimbal = self.create_publisher(Float32MultiArray, '/gimbal_state', 10)
        # 云台当前生效的限位：[轴号, 是否有效, 下限°, 上限°]（状态屏/上位机共用）
        self._pub_gimbal_limit = self.create_publisher(Float32MultiArray, '/gimbal_limits', 10)
        self._pub_tune = self.create_publisher(Float32MultiArray, '/tune_state', 10)  # [id, 生效值]
        self._pub_online = self.create_publisher(Bool, '/f407_online', 10)      # F407 是否有回传
        self._pub_ble = self.create_publisher(Bool, '/ble_connected', 10)       # 上行链路是否连着（有线=串口已打开，蓝牙=BLE 已连）

        # ================= 定时器 =================
        # 心跳 5Hz：F407 侧 500ms 收不到任何指令就会自主失能，必须比它快。
        self._heartbeat_timer = self.create_timer(0.2, self._on_heartbeat)
        # 收下行数据 50Hz：F407 侧里程计 50Hz、云台位置 20Hz、状态 5Hz。
        # 一次 poll 会把串口里积压的字节全读完，50Hz 只是把"到达延迟"压到 20ms 以内，
        # 不会丢帧；频率再低就会把 50Hz 里程计攒成一串突发帧发出去。
        self._poll_timer = self.create_timer(0.02, self._on_poll)
        # 链路状态 2Hz：发布"F407 是否在线 / 上行链路是否连着"，给状态屏和别的节点用。
        self._link_timer = self.create_timer(0.5, self._on_link_status)

        self._last_rx_s = 0.0          # 最近一次收到 F407 回传的时间
        self._last_online = None       # 上一次发布的在线状态（避免重复打印日志）
        self._last_ble = None
        # 记住最新的使能状态，心跳时一起重发。使能话题只在按键时来一次，
        # 那一帧如果赶上上行链路没连上（或丢包）就被丢掉了，F407 会永远停在
        # "未使能"——表现正是"蓝牙连着，但摇杆怎么推车都不动"。
        self._enable_state = False

        self.get_logger().info(f'桥接节点就绪：上行={type(self._up).__name__}，下行={self._down.device}')

    # ================= 链路创建 =================

    def _make_links(self):
        """建上行 + 下行链路。有线直连时收发共用同一条串口，返回同一个对象。

        为什么必须共用：wire + wire 时上下行走的是同一个 /dev/ttyAMA0，pyserial
        不允许两次打开同一串口文件，第二个会直接打不开。所以只建一个 PiCommLink，
        既负责发（send_xxx）又负责收（poll）。
        """
        up = str(self.get_parameter('uplink').value).lower()
        down = str(self.get_parameter('downlink').value).lower()
        if up == 'wire' and down == 'wire':
            device = self.get_parameter('wire_device').value
            baud = int(self.get_parameter('wire_baudrate').value)
            link = PiCommLink(device=device, baudrate=baud)
            self.get_logger().info(f'有线直连：{device} @ {baud}（上行 + 下行共用一条串口）')
            return link, link
        return self._make_uplink(), self._make_downlink()

    def _make_uplink(self):
        """按 uplink 参数建上行链路，返回的对象都提供 send_xxx() 方法。"""
        mode = str(self.get_parameter('uplink').value).lower()
        if mode == 'wire':
            device = self.get_parameter('wire_device').value
            baud = int(self.get_parameter('wire_baudrate').value)
            self.get_logger().info(f'上行：有线 {device} @ {baud}')
            return PiCommLink(device=device, baudrate=baud)
        if mode == 'rfcomm':
            device = self.get_parameter('rfcomm_device').value
            self.get_logger().info(f'上行：经典蓝牙 SPP {device}')
            return RfcommLink(device=device)
        # 默认走 BLE
        address = self.get_parameter('ble_address').value
        name = self.get_parameter('ble_name').value
        uuid = self.get_parameter('ble_write_uuid').value
        self.get_logger().info(
            f'上行：BLE（地址={address or "自动扫描"} 名字={name or "不限"}）'
        )
        return BleLink(
            address=address,
            name=name,
            write_uuid=uuid,
            scan_timeout=float(self.get_parameter('ble_scan_timeout').value),
            log=self.get_logger().info,
        )

    def _make_downlink(self):
        """按 downlink 参数建下行链路（只收）。"""
        mode = str(self.get_parameter('downlink').value).lower()
        if mode == 'wire':
            device = self.get_parameter('wire_device').value
            baud = int(self.get_parameter('wire_baudrate').value)
            self.get_logger().info(f'下行：有线 {device} @ {baud}')
        else:
            device = self.get_parameter('lora_device').value
            baud = int(self.get_parameter('lora_baudrate').value)
            self.get_logger().info(f'下行：LoRa {device} @ {baud}')
        return PiCommLink(device=device, baudrate=baud)

    # ---------------- 订阅回调（收到话题消息时自动执行） ----------------

    def _cb_cmd_vel(self, msg: Twist):
        """收到 /cmd_vel：把速度发给 F407（内部换算成 mm/s、mrad/s）。"""
        if not self._up.send_vel(msg.linear.x, msg.linear.y, msg.angular.z):
            self.get_logger().debug('VEL 发送失败', throttle_duration_sec=2.0)

    def _cb_cmd_servo(self, msg: Float32MultiArray):
        """收到 /cmd_servo：msg.data = [夹爪角度°, 托盘角度°, 相机角度°]，有几个发几个。"""
        if len(msg.data) >= 1:
            self._up.send_gripper(msg.data[0])
        if len(msg.data) >= 2:
            self._up.send_plate(msg.data[1])
        if len(msg.data) >= 3:
            self._up.send_cam(msg.data[2])

    def _cb_cmd_enable(self, msg: Bool):
        """收到 /cmd_enable：整车使能/失能（状态由心跳周期重发，见 _on_heartbeat）。"""
        self._enable_state = bool(msg.data)
        self._up.send_enable(self._enable_state)

    def _cb_cmd_pose(self, msg: Pose2D):
        """收到 /cmd_pose：把目标位姿发给 F407，位置+航向闭环在 F407 上执行。

        若做过 /set_odom 修正，目标位姿活在"修正坐标系"里，先减去偏移换回
        F407 的原始里程计系再下发。
        """
        x, y, th = self._remove_odom_offset(msg.x, msg.y, msg.theta)
        if not self._up.send_pose(x, y, th):
            self.get_logger().debug('POSE 发送失败', throttle_duration_sec=2.0)

    def _cb_cmd_gimbal(self, msg: Float32MultiArray):
        """收到 /cmd_gimbal：msg.data = [yaw°, lift°, extend°]。0=yaw 1=lift 2=extend。"""
        if len(msg.data) >= 1:
            self._up.send_gimbal(0, msg.data[0])
        if len(msg.data) >= 2:
            self._up.send_gimbal(1, msg.data[1])
        if len(msg.data) >= 3:
            self._up.send_gimbal(2, msg.data[2])

    def _cb_cmd_gimbal_vel(self, msg: Float32MultiArray):
        """收到 /cmd_gimbal_vel：msg.data = [yaw°/s, lift°/s, extend°/s]。速度模式（手柄）。"""
        if len(msg.data) >= 1:
            self._up.send_gimbal_vel(0, msg.data[0])
        if len(msg.data) >= 2:
            self._up.send_gimbal_vel(1, msg.data[1])
        if len(msg.data) >= 3:
            self._up.send_gimbal_vel(2, msg.data[2])

    def _cb_cmd_gimbal_home(self, msg: Int32):
        """收到 /cmd_gimbal_home：云台回零，mask bit0=yaw bit1=lift bit2=extend。"""
        mask = int(msg.data) & 0x07
        if mask:
            self._up.send_home(mask)

    def _cb_cmd_led(self, msg: Int32):
        """收到 /cmd_led：补光灯亮度 0~100%。"""
        self._up.send_led(float(msg.data))

    def _cb_cmd_gimbal_limit(self, msg: Float32MultiArray):
        """收到 /cmd_gimbal_limit：msg.data = [轴号, 下限°, 上限°]（限位示教结果）。"""
        if len(msg.data) >= 3:
            axis = int(msg.data[0])
            if 0 <= axis <= 2:
                self._up.send_gimbal_limit(axis, float(msg.data[1]), float(msg.data[2]))

    def _cb_cmd_gimbal_release(self, msg: Bool):
        """收到 /cmd_gimbal_release：True=松轴（电机控制板失能，可手拨），False=恢复。"""
        self._up.send_gimbal_release(bool(msg.data))

    def _cb_cmd_gimbal_zero(self, msg: Int32):
        """收到 /cmd_gimbal_zero：mask bit0=yaw bit1=lift bit2=extend，把当前位置记成 0 点。"""
        mask = int(msg.data) & 0x07
        if mask:
            self._up.send_gimbal_zero(mask)

    def _cb_cmd_tune(self, msg: Float32MultiArray):
        """收到 /cmd_tune：msg.data = [参数编号, 数值]，转成 PI_CMD_TUNE 发给 407。"""
        if len(msg.data) >= 2:
            param_id = int(round(msg.data[0]))
            self._up.send_tune(param_id, float(msg.data[1]))

    # ---------------- 里程计修正（/set_odom） ----------------

    def _cb_set_odom(self, msg: Pose2D):
        """把"修正坐标系"锚定到 msg 指定的真实位姿（圆环视觉矫正的收官动作）。

        偏移按绝对量记录：之后 odom' = t + R(t_yaw)·raw，重复重置互相覆盖。
        同时把 t 发布到 /odom_shift，让上位机把它的场地锚点做同样的平移，
        保证"场地 ↔ 里程计"换算在重置前后不变。
        F407 重启（掉线恢复）时偏移自动清零——它的原始里程计已经换了新零点。
        """
        if self._last_raw_odom is None:
            self.get_logger().warning('/set_odom 被忽略：还没收到过 F407 里程计')
            return
        rx, ry, rth = self._last_raw_odom
        dth = (msg.theta - rth + math.pi) % (2.0 * math.pi) - math.pi
        c, s = math.cos(dth), math.sin(dth)
        tx = msg.x - (c * rx - s * ry)
        ty = msg.y - (s * rx + c * ry)
        self._odom_offset = (tx, ty, dth)
        self._pub_odom_shift.publish(Pose2D(x=tx, y=ty, theta=dth))
        self.get_logger().info(
            f'里程计已重置：odom = ({tx:+.3f},{ty:+.3f})m '
            f'+ R({math.degrees(dth):+.1f}°)·raw')

    def _apply_odom_offset(self, x: float, y: float, th: float):
        """F407 原始里程计 → 修正坐标系：p' = t + R(t_yaw)·p。"""
        tx, ty, tth = self._odom_offset
        c, s = math.cos(tth), math.sin(tth)
        return (tx + c * x - s * y, ty + s * x + c * y, th + tth)

    def _remove_odom_offset(self, x: float, y: float, th: float):
        """修正坐标系 → F407 原始里程计（_apply_odom_offset 的逆变换）。"""
        tx, ty, tth = self._odom_offset
        c, s = math.cos(tth), math.sin(tth)
        px, py = x - tx, y - ty
        return (c * px + s * py, -s * px + c * py, th - tth)

    # ---------------- 定时器回调 ----------------

    def _on_heartbeat(self):
        """5Hz 心跳：告诉 F407 "树莓派还在"，否则它 500ms 就自主失能。

        顺便重发当前使能状态：F407 上电/掉线恢复后是失能的，使能帧只在按键时
        发一次，晚到的重连会让那一帧永远补不上。周期重发等于给使能状态买了保险。
        """
        self._up.send_heartbeat()
        self._up.send_enable(self._enable_state)

    def _on_poll(self):
        """50Hz 从下行串口收数据，可能一次收到多帧。"""
        for cmd, data in self._down.poll():
            self._last_rx_s = self.get_clock().now().nanoseconds / 1e9
            if cmd == RPT_ODOM:
                raw = parse_odom(data)
                self._last_raw_odom = raw
                self._publish_odom(raw)
            elif cmd == RPT_STATUS:
                state, err, mask = parse_status(data)
                self._pub_status.publish(Int32MultiArray(data=[state, err, mask]))
            elif cmd == RPT_GIMBAL:
                self._pub_gimbal.publish(
                    Float32MultiArray(data=[float(v) for v in parse_gimbal(data)]))
            elif cmd == RPT_GIMBAL_LIMIT:
                axis, valid, lo, hi = parse_gimbal_limit(data)
                self._pub_gimbal_limit.publish(
                    Float32MultiArray(data=[float(axis), 1.0 if valid else 0.0, lo, hi]))
            elif cmd == RPT_TUNE:
                param_id, value = parse_tune(data)
                self._pub_tune.publish(Float32MultiArray(data=[float(param_id), value]))

    def _on_link_status(self):
        """2Hz 发布链路状态，并在线状态变化时打一条日志。"""
        now_s = self.get_clock().now().nanoseconds / 1e9
        online = (now_s - self._last_rx_s) < F407_OFFLINE_TIMEOUT_S
        ble = bool(getattr(self._up, 'connected', False))

        self._pub_online.publish(Bool(data=online))
        self._pub_ble.publish(Bool(data=ble))

        if online != self._last_online:
            self._last_online = online
            if online:
                # F407 重新上线说明它重启过（或刚上电）：原始里程计换了新零点，
                # 旧的修正偏移继续叠加只会得到 garbage，直接清零（保守、可预期）。
                if self._odom_offset != (0.0, 0.0, 0.0):
                    self.get_logger().info('F407 重新上线：里程计修正偏移清零')
                self._odom_offset = (0.0, 0.0, 0.0)
                self.get_logger().info('F407 回传正常（链路通了）')
            else:
                self.get_logger().warning('F407 无回传：检查串口接线/波特率/共地')
        if ble != self._last_ble:
            self._last_ble = ble
            err = getattr(self._up, 'last_error', '')
            self.get_logger().info(f'上行链路{"已连接" if ble else "未连接"}{"" if ble else ("：" + err if err else "")}')

    def _publish_odom(self, pose):
        """把 (x米, y米, 朝向弧度) 组装成标准的里程计消息发出去。

        做过 /set_odom 修正时，先套偏移让 /odom 活在修正坐标系里。
        """
        x, y, theta = self._apply_odom_offset(*pose)
        msg = Odometry()
        msg.header.stamp = self.get_clock().now().to_msg()
        msg.header.frame_id = self.get_parameter('frame_id').value
        msg.pose.pose.position.x = x
        msg.pose.pose.position.y = y
        # 绕 Z 轴转 theta 的四元数是 (0, 0, sin(theta/2), cos(theta/2))
        q = Quaternion()
        q.z = math.sin(theta / 2.0)
        q.w = math.cos(theta / 2.0)
        msg.pose.pose.orientation = q
        self._pub_odom.publish(msg)


def main(args=None):
    rclpy.init(args=args)
    node = F407BridgeNode()
    try:
        rclpy.spin(node)
    except KeyboardInterrupt:
        pass
    finally:
        try:
            node._up.close()
            node._down.close()
        except Exception:
            pass
        node.destroy_node()
        rclpy.shutdown()


if __name__ == '__main__':
    main()
