kblueseek/GongChuang/(commit log)

2026-09-20 init: 电控代码项目初建立
2026-09-22 添加了一些文档
2026-09-23 创建了keil工程，还没开始写代码
2026-09-24 添加了麦轮驱动程序
2026-09-29 加了设计文档
2026-10-01 现在开始用f407的板子
2026-10-09 位置闭环初版，全面使用can通信
2026-10-09 更新了文档
2026-10-09 添加视觉代码
2026-10-09 构建了pi代码
2026-10-10 加入了上位机
2026-10-11 打通了pi的链路
2026-10-13 加入了要遥控器的代码
2026-10-15 更新了遥控器，更新使能逻辑
2026-10-23 加入了Lora，使用手柄控制，底盘位置闭环尚不确定
2026-10-24 树莓派和407的通信问题还没有解决
2026-10-24 手柄映射完备，位置闭环精度足够，航向环需要调整
2026-10-25 融合雷达上位机,实现简易路径规划
2026-10-28 加入了云台
2026-10-30 云台一坨
2026-10-31 云台速度模式调通，加入了限位设置
2026-10-31 基本实现物料追踪
2026-11-01 经过简单调参,定义抓取逻辑
2026-11-04 更新上位机
2026-11-04 上位机优化
2026-11-04 加入视觉矫正
2026-11-04 第一版paotu
2026-11-05 修正横纵移动差异
2026-11-05 跑图完善
2026-11-10 优化上位机转向逻辑，增加颜色拾取动作
2026-11-11 实现物料抓取，可调整性尚可提高
2026-11-12 实现摄像头预热
2026-11-12 三物料抓取，速度仍可优化
