kblueseek/GongChuang/(notices)

Notices in the files:
Universalcar_103/Core/Src/can.c:
Copyright (c) 2026 STMicroelectronics.
All rights reserved.
This software is licensed under terms that can be found in the LICENSE file
